DRuffer/eP16VHDL/eP16/compile.cfg

[file:.\..\gpio16.vhd]
Enabled=1
[file:.\..\ram_memory.vhd]
Enabled=1
[file:.\..\uart16.vhd]
Enabled=1
[file:.\..\ep16.vhd]
Enabled=1
[file:.\..\ep16_chip.vhd]
Enabled=1
[View]
Entity=ep32_chip
Architecture=behavioral
TopLevelType=1
[file:.\src\eP16.asdb]
Enabled=1
[file:.\src\eP16.awc]
Enabled=1
