DRuffer/eP16VHDL/eP16/ep32_chip_prim.v

// Verilog netlist produced by program LSE :  version Diamond (64-bit) 3.7.1.502
// Netlist written on Sun Jun 19 19:47:01 2016
//
// Verilog Description of module ep32_chip
//

module ep32_chip (aclk, arst, interrupt_i, uart_i, uart_o, acknowledge_o, 
            ioport);   // c:/lscc/ep16vhdl/ep16_chip.vhd(33[8:17])
    input aclk;   // c:/lscc/ep16vhdl/ep16_chip.vhd(36[2:6])
    input arst;   // c:/lscc/ep16vhdl/ep16_chip.vhd(37[2:6])
    input [4:0]interrupt_i;   // c:/lscc/ep16vhdl/ep16_chip.vhd(38[2:13])
    input uart_i;   // c:/lscc/ep16vhdl/ep16_chip.vhd(39[2:8])
    output uart_o;   // c:/lscc/ep16vhdl/ep16_chip.vhd(41[2:8])
    output acknowledge_o;   // c:/lscc/ep16vhdl/ep16_chip.vhd(42[2:15])
    inout [15:0]ioport;   // c:/lscc/ep16vhdl/ep16_chip.vhd(44[2:8])
    
    wire aclk_c /* synthesis SET_AS_NETWORK=aclk_c, is_clock=1 */ ;   // c:/lscc/ep16vhdl/ep16_chip.vhd(36[2:6])
    wire aclk_N_55 /* synthesis is_clock=1 */ ;   // c:/lscc/ep16vhdl/ep16_chip.vhd(121[9:14])
    
    wire GND_net, VCC_net, arst_c, interrupt_i_c_4, interrupt_i_c_3, 
        interrupt_i_c_2, interrupt_i_c_1, interrupt_i_c_0, uart_i_c, 
        uart_o_c, acknowledge_o_c, n7695;
    wire [15:0]memory_data_o;   // c:/lscc/ep16vhdl/ep16_chip.vhd(122[9:22])
    wire [15:0]memory_data_i;   // c:/lscc/ep16vhdl/ep16_chip.vhd(123[9:22])
    wire [11:0]memory_addr;   // c:/lscc/ep16vhdl/ep16_chip.vhd(124[9:20])
    wire [15:0]system_data_o;   // c:/lscc/ep16vhdl/ep16_chip.vhd(128[9:22])
    
    wire system_read, system_write, n7025, n1171, n1169, n1168, 
        n1167, n1166, n1165, n1164, n1163, n1162;
    wire [15:0]gpio_out;   // c:/lscc/ep16vhdl/ep16_chip.vhd(162[9:17])
    wire [15:0]gpio_dir;   // c:/lscc/ep16vhdl/ep16_chip.vhd(163[9:17])
    
    wire n7694, system_data_o_15__N_2, n7693, system_data_o_15__N_51, 
        system_data_o_15__N_7, system_data_o_15__N_10, system_data_o_15__N_13, 
        system_data_o_15__N_16, system_data_o_15__N_19, system_data_o_15__N_22, 
        system_data_o_15__N_25, system_data_o_15__N_28, n7692, system_data_o_15__N_31, 
        system_data_o_15__N_34, n7691, system_data_o_15__N_37, system_data_o_15__N_40, 
        n7690, system_data_o_15__N_43, system_data_o_15__N_46, system_data_o_15__N_49;
    wire [2:0]slot;   // c:/lscc/ep16vhdl/ep16.vhd(48[9:13])
    wire [4:0]sp;   // c:/lscc/ep16vhdl/ep16.vhd(49[9:11])
    wire [4:0]sp1;   // c:/lscc/ep16vhdl/ep16.vhd(49[12:15])
    wire [4:0]rp;   // c:/lscc/ep16vhdl/ep16.vhd(49[16:18])
    wire [4:0]rp1;   // c:/lscc/ep16vhdl/ep16.vhd(49[19:22])
    wire [16:0]t;   // c:/lscc/ep16vhdl/ep16.vhd(50[9:10])
    wire [16:0]a;   // c:/lscc/ep16vhdl/ep16.vhd(51[9:10])
    wire [16:0]r;   // c:/lscc/ep16vhdl/ep16.vhd(51[11:12])
    wire [2:0]p_sel;   // c:/lscc/ep16vhdl/ep16.vhd(55[9:14])
    wire [15:0]i;   // c:/lscc/ep16vhdl/ep16.vhd(62[9:10])
    wire [15:0]p;   // c:/lscc/ep16vhdl/ep16.vhd(62[11:12])
    wire [15:0]p_in;   // c:/lscc/ep16vhdl/ep16.vhd(62[13:17])
    wire [15:0]p_in_15__N_282;
    
    wire n8631, n7689, n7688, n7687, n7686, n19, n26, n28, n6903, 
        n1411, n6901, n1406, n1401, n1396, n7685, n1391, n1386, 
        n7684, n7683, n1381, n7682, n1376, n7680, n7679, n1371, 
        n1366, n1361, n1356, n1351, n1346, n7678, aclk_c_enable_37, 
        n1341, n7677, n1336, n1335, n1334, n1333, n1332, n1331, 
        n1330, n1329, n1328, n1327, n1326, n1325, n1324, n1323, 
        n1322, n1321, n1317, n1314, n1519, n1518, n1517, n1516, 
        n1515, n1514, n1513, n1512, n1511, n1510, n1509, n1508, 
        n1507, n1506, n1505, n1504, n1503, n1502, n1501, n1500, 
        n1530, n1529, n78, n1424, n7676, n1528, n7675, n1498, 
        n1312, n1309, n1497, n1495, n1494, n1493, n1492, n1491, 
        n1490, n1489, n1488, n1487, n1486, n1485, n1484, n1483, 
        n1482, n1527, n1526, n1525, n1524, n1523, n1416, n1419, 
        n1522, n1521, n1520, n963, n1305, n1481, n1480, n1479, 
        n1478, n1477;
    wire [15:0]baudrate_reg;   // c:/lscc/ep16vhdl/uart16.vhd(50[9:21])
    
    wire hw_xonoff_ff, tx_en;
    wire [15:0]tx_counter;   // c:/lscc/ep16vhdl/uart16.vhd(57[9:19])
    wire [7:0]rx_buffer_reg;   // c:/lscc/ep16vhdl/uart16.vhd(61[9:22])
    
    wire rxb_full, rx_en, rxd_ff, data_o_15__N_441, n1463, n1462, 
        n7161, n6893, n6891, n7674, n7673, n7672, n7671, n1301, 
        n1304, n7670, n1296, aclk_c_enable_21, n1291, n1286, n1281, 
        n1276, n1271, tx_en_N_533, n7407, n7011, n1091, n1093, 
        n1094, n1095, n1096, n1097, n1098, n1099, n7669, n1476, 
        n1475, n6376, n7668, n7667, n8630, rx_irq_o_N_643, n1474, 
        n1536, n1534, n1533, n1532;
    wire [15:0]rx_counter_15__N_609;
    
    wire n1537, n1531, n1473, n1266, n8245, n1261, n1256, n1251, 
        n1246, n1241, n1236, n1231, n1226, n1435, n1432, n1429, 
        n1427, n7411, n6655, n5, n3860, n1084, n9433, n1465, 
        n1464, n1178, n1468, n1466, n1467, n1469, n1470, n1471, 
        n1472, n7001, n8629, n780, n8628, n66, n63, n1996, n8744, 
        n8743, n8741, n8627, n8740, n8738, aclk_c_enable_123, n8626, 
        n8737, n75, n8735, n72, n8734, n8732, n69, n66_adj_901, 
        n69_adj_902, n72_adj_903, n75_adj_904, n78_adj_905, n81, n8731, 
        n7405, aclk_c_enable_16, n8625, n8624, n8623, n8622, n8698, 
        n7611, n7, n3, n1, ioport_out_15, n1853, ioport_out_14, 
        n1855, ioport_out_13, n1857, ioport_out_12, n1859, ioport_out_11, 
        n1861, ioport_out_10, n1863, ioport_out_9, n1865, ioport_out_8, 
        n1867, ioport_out_7, n1869, ioport_out_6, n1871, ioport_out_5, 
        n1873, ioport_out_4, n1875, ioport_out_3, n1877, ioport_out_2, 
        n1879, ioport_out_1, n1881, ioport_out_0, n1883, n8621, 
        n8620, n7595, n8619, n8618, n8617, n8616, n8615, n8614, 
        n8613, n8612, aclk_c_enable_78, n8608, n6835, n8607, n8606, 
        n6833, n8604, n8603, n8602, n8601, n8599, n6537, n8596, 
        n7105, n6010, n30, n4113, n4114, n19_adj_906, n26_adj_907, 
        n28_adj_908, n4, n6, n30_adj_909, n4083, n4084, n19_adj_910, 
        aclk_c_enable_29, n26_adj_911, n1_adj_912, n28_adj_913, n3_adj_914, 
        n30_adj_915, n4053, n4054, n19_adj_916, n26_adj_917, n28_adj_918, 
        n30_adj_919, n4023, n4024, n8675, n7570, n19_adj_920, n7569, 
        n8674, n26_adj_921, n28_adj_922, n8673, n8671, n30_adj_923, 
        n7568, n3993, n3994, n7567, n19_adj_924, n7566, n26_adj_925, 
        n28_adj_926, n7565, n7564, n30_adj_927, n3963, n3964, n8668, 
        n8667, aclk_c_enable_15, n7403, n8666, n8664, n8663, n8592, 
        n8699, n7563, n7562, n8661, n8660, n7561, n7560, aclk_c_enable_18, 
        n7559, n7558, n7557, n7556, n8653, n7555, n7554, n7553, 
        n7552, n7551, n7550, n8651, n7549, n7548, n7547, n7546, 
        n7545, n7544, n7543, n7542, n8640, n18, n7541, n7540, 
        n7733, n7732, n7539, n8637, n7731, n7730, n7729, n7728, 
        n7727, n7726, n7725, n7724, n7723, n8634, n7043, n7722, 
        n8633, n6766, n7721, n7720, n7719, n7717, n7716, n7715, 
        n7714, n7713, n7712, n7711, n7401, n7710, n7709, n7708, 
        n7027, n7707, n7706, n7705, n7704, n8632;
    
    VHI i2 (.Z(VCC_net));
    INV i8039 (.A(aclk_c), .Z(aclk_N_55));   // c:/lscc/ep16vhdl/ep16_chip.vhd(36[2:6])
    FD1P3AX creset_712 (.D(n7539), .SP(aclk_c_enable_16), .CK(aclk_c), 
            .Q(n1301));   // c:/lscc/ep16vhdl/ep16.vhd(47[9:16])
    defparam creset_712.GSR = "ENABLED";
    FD1P3AX creset_724 (.D(n7540), .SP(aclk_c_enable_78), .CK(aclk_c), 
            .Q(n1351));   // c:/lscc/ep16vhdl/ep16.vhd(47[17:24])
    defparam creset_724.GSR = "ENABLED";
    FD1P3AX creset_720 (.D(n7541), .SP(aclk_c_enable_78), .CK(aclk_c), 
            .Q(n1346));   // c:/lscc/ep16vhdl/ep16.vhd(47[17:24])
    defparam creset_720.GSR = "ENABLED";
    FD1P3AX creset_716 (.D(n7542), .SP(aclk_c_enable_78), .CK(aclk_c), 
            .Q(n1341));   // c:/lscc/ep16vhdl/ep16.vhd(47[17:24])
    defparam creset_716.GSR = "ENABLED";
    DPR16X4B n13130 (.DI0(n8674), .DI1(GND_net), .DI2(GND_net), .DI3(GND_net), 
            .WAD0(sp1[0]), .WAD1(sp1[1]), .WAD2(sp1[2]), .WAD3(sp1[3]), 
            .WCK(aclk_c), .WRE(n1309), .RAD0(sp[0]), .RAD1(sp[1]), .RAD2(sp[2]), 
            .RAD3(sp[3]), .DO0(n1314));
    defparam n13130.initval = 64'h0000000000000000;
    DPR16X4B n14310 (.DI0(rp1[4]), .DI1(GND_net), .DI2(GND_net), .DI3(GND_net), 
            .WAD0(rp1[0]), .WAD1(rp1[1]), .WAD2(rp1[2]), .WAD3(rp1[3]), 
            .WCK(aclk_c), .WRE(n1427), .RAD0(rp[0]), .RAD1(rp[1]), .RAD2(rp[2]), 
            .RAD3(rp[3]), .DO0(n1432));
    defparam n14310.initval = 64'h0000000000000000;
    FD1P3AX creset_688 (.D(n7543), .SP(aclk_c_enable_16), .CK(aclk_c), 
            .Q(n1291));   // c:/lscc/ep16vhdl/ep16.vhd(47[9:16])
    defparam creset_688.GSR = "ENABLED";
    FD1P3AX creset_684 (.D(n7544), .SP(aclk_c_enable_16), .CK(aclk_c), 
            .Q(n1286));   // c:/lscc/ep16vhdl/ep16.vhd(47[9:16])
    defparam creset_684.GSR = "ENABLED";
    FD1P3AX creset_640 (.D(n7545), .SP(aclk_c_enable_21), .CK(aclk_c), 
            .Q(n1231));   // c:/lscc/ep16vhdl/ep16.vhd(47[9:16])
    defparam creset_640.GSR = "ENABLED";
    FD1P3AX creset_680 (.D(n7546), .SP(aclk_c_enable_37), .CK(aclk_c), 
            .Q(n1281));   // c:/lscc/ep16vhdl/ep16.vhd(47[9:16])
    defparam creset_680.GSR = "ENABLED";
    FD1P3AX creset_644 (.D(n7547), .SP(aclk_c_enable_21), .CK(aclk_c), 
            .Q(n1236));   // c:/lscc/ep16vhdl/ep16.vhd(47[9:16])
    defparam creset_644.GSR = "ENABLED";
    BB ioport_pad_15 (.I(gpio_out[15]), .T(n1853), .B(ioport[15]), .O(ioport_out_15));   // c:/lscc/ep16vhdl/ep16_chip.vhd(44[2:8])
    FD1P3AX creset (.D(n7548), .SP(aclk_c_enable_78), .CK(aclk_c), .Q(n1416));   // c:/lscc/ep16vhdl/ep16.vhd(47[17:24])
    defparam creset.GSR = "ENABLED";
    DPR16X4B r_stack1 (.DI0(r[13]), .DI1(r[14]), .DI2(r[15]), .DI3(r[16]), 
            .WAD0(rp1[0]), .WAD1(rp1[1]), .WAD2(rp1[2]), .WAD3(rp1[3]), 
            .WCK(aclk_c), .WRE(n1536), .RAD0(rp[0]), .RAD1(rp[1]), .RAD2(rp[2]), 
            .RAD3(rp[3]), .DO0(n1514), .DO1(n1515), .DO2(n1516), .DO3(n1517));
    defparam r_stack1.initval = 64'h0000000000000000;
    FD1P3AX creset_740 (.D(n7549), .SP(aclk_c_enable_78), .CK(aclk_c), 
            .Q(n1371));   // c:/lscc/ep16vhdl/ep16.vhd(47[17:24])
    defparam creset_740.GSR = "ENABLED";
    FD1P3AX creset_772 (.D(n7550), .SP(aclk_c_enable_78), .CK(aclk_c), 
            .Q(n1411));   // c:/lscc/ep16vhdl/ep16.vhd(47[17:24])
    defparam creset_772.GSR = "ENABLED";
    DPR16X4B s_stack1 (.DI0(memory_data_i[13]), .DI1(memory_data_i[14]), 
            .DI2(memory_data_i[15]), .DI3(t[16]), .WAD0(sp1[0]), .WAD1(sp1[1]), 
            .WAD2(sp1[2]), .WAD3(sp1[3]), .WCK(aclk_c), .WRE(n1497), 
            .RAD0(sp[0]), .RAD1(sp[1]), .RAD2(sp[2]), .RAD3(sp[3]), 
            .DO0(n1475), .DO1(n1476), .DO2(n1477), .DO3(n1478));
    defparam s_stack1.initval = 64'h0000000000000000;
    PFUMX i17 (.BLUT(n19_adj_910), .ALUT(n26_adj_911), .C0(data_o_15__N_441), 
          .Z(n28_adj_913));
    ORCALUT4 mux_595_i1_3_lut (.A(gpio_out[0]), .B(baudrate_reg[0]), .C(data_o_15__N_441), 
            .Z(n1178)) /* synthesis lut_function=(A (B+!(C))+!A (B (C))) */ ;   // c:/lscc/ep16vhdl/uart16.vhd(80[2] 95[9])
    defparam mux_595_i1_3_lut.init = 16'hcaca;
    FD1P3AX creset_656 (.D(n7551), .SP(aclk_c_enable_15), .CK(aclk_c), 
            .Q(n1251));   // c:/lscc/ep16vhdl/ep16.vhd(47[9:16])
    defparam creset_656.GSR = "ENABLED";
    FD1P3AX creset_692 (.D(n7552), .SP(aclk_c_enable_16), .CK(aclk_c), 
            .Q(n1296));   // c:/lscc/ep16vhdl/ep16.vhd(47[9:16])
    defparam creset_692.GSR = "ENABLED";
    FD1P3AX creset_648 (.D(n7553), .SP(aclk_c_enable_21), .CK(aclk_c), 
            .Q(n1241));   // c:/lscc/ep16vhdl/ep16.vhd(47[9:16])
    defparam creset_648.GSR = "ENABLED";
    FD1P3AX creset_664 (.D(n7554), .SP(aclk_c_enable_18), .CK(aclk_c), 
            .Q(n1261));   // c:/lscc/ep16vhdl/ep16.vhd(47[9:16])
    defparam creset_664.GSR = "ENABLED";
    FD1P3AX creset_676 (.D(n7555), .SP(aclk_c_enable_37), .CK(aclk_c), 
            .Q(n1276));   // c:/lscc/ep16vhdl/ep16.vhd(47[9:16])
    defparam creset_676.GSR = "ENABLED";
    FD1P3AX creset_768 (.D(n7556), .SP(aclk_c_enable_78), .CK(aclk_c), 
            .Q(n1406));   // c:/lscc/ep16vhdl/ep16.vhd(47[17:24])
    defparam creset_768.GSR = "ENABLED";
    PFUMX i17_adj_206 (.BLUT(n19_adj_906), .ALUT(n26_adj_907), .C0(data_o_15__N_441), 
          .Z(n28_adj_908));
    FD1P3AX creset_636 (.D(n7557), .SP(aclk_c_enable_21), .CK(aclk_c), 
            .Q(n1226));   // c:/lscc/ep16vhdl/ep16.vhd(47[9:16])
    defparam creset_636.GSR = "ENABLED";
    FD1P3AX creset_652 (.D(n7558), .SP(aclk_c_enable_29), .CK(aclk_c), 
            .Q(n1246));   // c:/lscc/ep16vhdl/ep16.vhd(47[9:16])
    defparam creset_652.GSR = "ENABLED";
    gpio gpio1 (.\memory_addr[1] (memory_addr[1]), .tx_en(tx_en), .hw_xonoff_ff(hw_xonoff_ff), 
         .n8616(n8616), .\memory_addr[4] (memory_addr[4]), .n8617(n8617), 
         .\memory_addr[5] (memory_addr[5]), .n7401(n7401), .n8615(n8615), 
         .n7405(n7405), .n8622(n8622), .gpio_out({gpio_out}), .gpio_dir({gpio_dir}), 
         .\baudrate_reg[8] (baudrate_reg[8]), .rxb_full(rxb_full), .ioport_out_8(ioport_out_8), 
         .aclk_c(aclk_c), .aclk_c_enable_123(aclk_c_enable_123), .system_data_o({system_data_o}), 
         .data_o_15__N_441(data_o_15__N_441), .n8245(n8245), .n8603(n8603), 
         .n8602(n8602), .n8618(n8618), .n18(n18), .n8604(n8604), .n8608(n8608), 
         .ioport_out_13(ioport_out_13), .n8592(n8592), .n1084(n1084), 
         .ioport_out_15(ioport_out_15), .ioport_out_14(ioport_out_14), .\rx_buffer_reg[0] (rx_buffer_reg[0]), 
         .n1163(n1163), .n7611(n7611), .n1099(n1099), .n1164(n1164), 
         .n1098(n1098), .n1165(n1165), .n1097(n1097), .n1166(n1166), 
         .n1096(n1096), .n1167(n1167), .n1095(n1095), .n1168(n1168), 
         .n1094(n1094), .n1169(n1169), .n1093(n1093), .n1091(n1091), 
         .n1178(n1178), .n1162(n1162), .ioport_out_12(ioport_out_12), 
         .n7407(n7407), .ioport_out_11(ioport_out_11), .ioport_out_10(ioport_out_10), 
         .ioport_out_9(ioport_out_9), .n1171(n1171), .ioport_out_7(ioport_out_7), 
         .\rx_buffer_reg[7] (rx_buffer_reg[7]), .ioport_out_0(ioport_out_0));   // c:/lscc/ep16vhdl/ep16_chip.vhd(252[11:15])
    ORCALUT4 i3516_2_lut_rep_250_3_lut (.A(n8664), .B(n1305), .C(n1334), 
            .Z(n8630)) /* synthesis lut_function=(A (B (C))) */ ;   // c:/lscc/ep16vhdl/ep16.vhd(47[9:16])
    defparam i3516_2_lut_rep_250_3_lut.init = 16'h8080;
    FD1P3AX creset_660 (.D(n7559), .SP(aclk_c_enable_29), .CK(aclk_c), 
            .Q(n1256));   // c:/lscc/ep16vhdl/ep16.vhd(47[9:16])
    defparam creset_660.GSR = "ENABLED";
    FD1P3AX creset_672 (.D(n7560), .SP(aclk_c_enable_37), .CK(aclk_c), 
            .Q(n1271));   // c:/lscc/ep16vhdl/ep16.vhd(47[9:16])
    defparam creset_672.GSR = "ENABLED";
    ORCALUT4 i1188_4_lut (.A(system_data_o_15__N_13), .B(system_data_o_15__N_51), 
            .C(memory_data_i[12]), .D(system_write), .Z(system_data_o[12])) /* synthesis lut_function=(A (B (C+!(D)))+!A (B (C (D)))) */ ;   // c:/lscc/ep16vhdl/ep16_chip.vhd(198[2:15])
    defparam i1188_4_lut.init = 16'hc088;
    ORCALUT4 mux_470_i13_4_lut (.A(memory_data_o[12]), .B(n1096), .C(n8618), 
            .D(n6537), .Z(system_data_o_15__N_13)) /* synthesis lut_function=(A (B+!(C (D)))+!A (B (C)+!B !((D)+!C))) */ ;   // c:/lscc/ep16vhdl/uart16.vhd(80[2] 95[9])
    defparam mux_470_i13_4_lut.init = 16'hcafa;
    ORCALUT4 i3404_4_lut_then_4_lut (.A(n8660), .B(n66_adj_901), .C(rx_irq_o_N_643), 
            .D(baudrate_reg[5]), .Z(n8732)) /* synthesis lut_function=(A (B (C+(D))+!B !(C+!(D)))+!A (B (C))) */ ;   // c:/lscc/ep16vhdl/uart16.vhd(39[3:11])
    defparam i3404_4_lut_then_4_lut.init = 16'hcac0;
    ORCALUT4 i3404_4_lut_else_4_lut (.A(baudrate_reg[6]), .B(rxd_ff), .Z(n8731)) /* synthesis lut_function=(!((B)+!A)) */ ;   // c:/lscc/ep16vhdl/uart16.vhd(39[3:11])
    defparam i3404_4_lut_else_4_lut.init = 16'h2222;
    ORCALUT4 i3373_4_lut_then_4_lut (.A(n8660), .B(n69_adj_902), .C(rx_irq_o_N_643), 
            .D(baudrate_reg[4]), .Z(n8735)) /* synthesis lut_function=(A (B (C+(D))+!B !(C+!(D)))+!A (B (C))) */ ;   // c:/lscc/ep16vhdl/uart16.vhd(39[3:11])
    defparam i3373_4_lut_then_4_lut.init = 16'hcac0;
    ORCALUT4 i3373_4_lut_else_4_lut (.A(baudrate_reg[5]), .B(rxd_ff), .Z(n8734)) /* synthesis lut_function=(!((B)+!A)) */ ;   // c:/lscc/ep16vhdl/uart16.vhd(39[3:11])
    defparam i3373_4_lut_else_4_lut.init = 16'h2222;
    ORCALUT4 i3342_4_lut_then_4_lut (.A(n8660), .B(n72_adj_903), .C(rx_irq_o_N_643), 
            .D(baudrate_reg[3]), .Z(n8738)) /* synthesis lut_function=(A (B (C+(D))+!B !(C+!(D)))+!A (B (C))) */ ;   // c:/lscc/ep16vhdl/uart16.vhd(39[3:11])
    defparam i3342_4_lut_then_4_lut.init = 16'hcac0;
    ORCALUT4 i3342_4_lut_else_4_lut (.A(baudrate_reg[4]), .B(rxd_ff), .Z(n8737)) /* synthesis lut_function=(!((B)+!A)) */ ;   // c:/lscc/ep16vhdl/uart16.vhd(39[3:11])
    defparam i3342_4_lut_else_4_lut.init = 16'h2222;
    ORCALUT4 i3514_2_lut_rep_249_3_lut (.A(n8664), .B(n1305), .C(n1336), 
            .Z(n8629)) /* synthesis lut_function=(A (B (C))) */ ;   // c:/lscc/ep16vhdl/ep16.vhd(47[9:16])
    defparam i3514_2_lut_rep_249_3_lut.init = 16'h8080;
    ORCALUT4 i3311_4_lut_then_4_lut (.A(n8660), .B(n75_adj_904), .C(rx_irq_o_N_643), 
            .D(baudrate_reg[2]), .Z(n8741)) /* synthesis lut_function=(A (B (C+(D))+!B !(C+!(D)))+!A (B (C))) */ ;   // c:/lscc/ep16vhdl/uart16.vhd(39[3:11])
    defparam i3311_4_lut_then_4_lut.init = 16'hcac0;
    FD1P3AX creset_668 (.D(n7561), .SP(aclk_c_enable_37), .CK(aclk_c), 
            .Q(n1266));   // c:/lscc/ep16vhdl/ep16.vhd(47[9:16])
    defparam creset_668.GSR = "ENABLED";
    FD1P3AX creset_764 (.D(n7562), .SP(aclk_c_enable_78), .CK(aclk_c), 
            .Q(n1401));   // c:/lscc/ep16vhdl/ep16.vhd(47[17:24])
    defparam creset_764.GSR = "ENABLED";
    ORCALUT4 i3311_4_lut_else_4_lut (.A(baudrate_reg[3]), .B(rxd_ff), .Z(n8740)) /* synthesis lut_function=(!((B)+!A)) */ ;   // c:/lscc/ep16vhdl/uart16.vhd(39[3:11])
    defparam i3311_4_lut_else_4_lut.init = 16'h2222;
    ORCALUT4 i1190_4_lut (.A(system_data_o_15__N_7), .B(system_data_o_15__N_51), 
            .C(memory_data_i[14]), .D(system_write), .Z(system_data_o[14])) /* synthesis lut_function=(A (B (C+!(D)))+!A (B (C (D)))) */ ;   // c:/lscc/ep16vhdl/ep16_chip.vhd(198[2:15])
    defparam i1190_4_lut.init = 16'hc088;
    FD1P3AX creset_760 (.D(n7563), .SP(aclk_c_enable_78), .CK(aclk_c), 
            .Q(n1396));   // c:/lscc/ep16vhdl/ep16.vhd(47[17:24])
    defparam creset_760.GSR = "ENABLED";
    FD1P3AX creset_736 (.D(n7564), .SP(aclk_c_enable_78), .CK(aclk_c), 
            .Q(n1366));   // c:/lscc/ep16vhdl/ep16.vhd(47[17:24])
    defparam creset_736.GSR = "ENABLED";
    FD1P3AX creset_732 (.D(n7565), .SP(aclk_c_enable_78), .CK(aclk_c), 
            .Q(n1361));   // c:/lscc/ep16vhdl/ep16.vhd(47[17:24])
    defparam creset_732.GSR = "ENABLED";
    FD1P3AX creset_756 (.D(n7566), .SP(aclk_c_enable_78), .CK(aclk_c), 
            .Q(n1391));   // c:/lscc/ep16vhdl/ep16.vhd(47[17:24])
    defparam creset_756.GSR = "ENABLED";
    FD1P3AX creset_752 (.D(n7567), .SP(aclk_c_enable_78), .CK(aclk_c), 
            .Q(n1386));   // c:/lscc/ep16vhdl/ep16.vhd(47[17:24])
    defparam creset_752.GSR = "ENABLED";
    ORCALUT4 mux_470_i15_4_lut (.A(memory_data_o[14]), .B(n1098), .C(n8618), 
            .D(n6537), .Z(system_data_o_15__N_7)) /* synthesis lut_function=(A (B+!(C (D)))+!A (B (C)+!B !((D)+!C))) */ ;   // c:/lscc/ep16vhdl/uart16.vhd(80[2] 95[9])
    defparam mux_470_i15_4_lut.init = 16'hcafa;
    FD1P3AX creset_748 (.D(n7568), .SP(aclk_c_enable_78), .CK(aclk_c), 
            .Q(n1381));   // c:/lscc/ep16vhdl/ep16.vhd(47[17:24])
    defparam creset_748.GSR = "ENABLED";
    FD1P3AX creset_744 (.D(n7569), .SP(aclk_c_enable_78), .CK(aclk_c), 
            .Q(n1376));   // c:/lscc/ep16vhdl/ep16.vhd(47[17:24])
    defparam creset_744.GSR = "ENABLED";
    DPR16X4B n14280 (.DI0(n1500), .DI1(GND_net), .DI2(GND_net), .DI3(GND_net), 
            .WAD0(rp1[0]), .WAD1(rp1[1]), .WAD2(rp1[2]), .WAD3(rp1[3]), 
            .WCK(aclk_c), .WRE(n1424), .RAD0(rp[0]), .RAD1(rp[1]), .RAD2(rp[2]), 
            .RAD3(rp[3]), .DO0(n1429));
    defparam n14280.initval = 64'h0000000000000000;
    ORCALUT4 i3280_4_lut_then_4_lut (.A(n8660), .B(n78_adj_905), .C(rx_irq_o_N_643), 
            .D(baudrate_reg[1]), .Z(n8744)) /* synthesis lut_function=(A (B (C+(D))+!B !(C+!(D)))+!A (B (C))) */ ;   // c:/lscc/ep16vhdl/uart16.vhd(39[3:11])
    defparam i3280_4_lut_then_4_lut.init = 16'hcac0;
    DPR16X4B s_stack0 (.DI0(memory_data_i[13]), .DI1(memory_data_i[14]), 
            .DI2(memory_data_i[15]), .DI3(t[16]), .WAD0(sp1[0]), .WAD1(sp1[1]), 
            .WAD2(sp1[2]), .WAD3(sp1[3]), .WCK(aclk_c), .WRE(n1498), 
            .RAD0(sp[0]), .RAD1(sp[1]), .RAD2(sp[2]), .RAD3(sp[3]), 
            .DO0(n1492), .DO1(n1493), .DO2(n1494), .DO3(n1495));
    defparam s_stack0.initval = 64'h0000000000000000;
    ORCALUT4 i3280_4_lut_else_4_lut (.A(baudrate_reg[2]), .B(rxd_ff), .Z(n8743)) /* synthesis lut_function=(!((B)+!A)) */ ;   // c:/lscc/ep16vhdl/uart16.vhd(39[3:11])
    defparam i3280_4_lut_else_4_lut.init = 16'h2222;
    DPR16X4B s_stack2 (.DI0(memory_data_i[9]), .DI1(memory_data_i[10]), 
            .DI2(memory_data_i[11]), .DI3(memory_data_i[12]), .WAD0(sp1[0]), 
            .WAD1(sp1[1]), .WAD2(sp1[2]), .WAD3(sp1[3]), .WCK(aclk_c), 
            .WRE(n1497), .RAD0(sp[0]), .RAD1(sp[1]), .RAD2(sp[2]), .RAD3(sp[3]), 
            .DO0(n1471), .DO1(n1472), .DO2(n1473), .DO3(n1474));
    defparam s_stack2.initval = 64'h0000000000000000;
    DPR16X4B s_stack3 (.DI0(memory_data_i[5]), .DI1(memory_data_i[6]), .DI2(memory_data_i[7]), 
            .DI3(memory_data_i[8]), .WAD0(sp1[0]), .WAD1(sp1[1]), .WAD2(sp1[2]), 
            .WAD3(sp1[3]), .WCK(aclk_c), .WRE(n1497), .RAD0(sp[0]), 
            .RAD1(sp[1]), .RAD2(sp[2]), .RAD3(sp[3]), .DO0(n1467), .DO1(n1468), 
            .DO2(n1469), .DO3(n1470));
    defparam s_stack3.initval = 64'h0000000000000000;
    DPR16X4B s_stack4 (.DI0(memory_data_i[1]), .DI1(memory_data_i[2]), .DI2(memory_data_i[3]), 
            .DI3(memory_data_i[4]), .WAD0(sp1[0]), .WAD1(sp1[1]), .WAD2(sp1[2]), 
            .WAD3(sp1[3]), .WCK(aclk_c), .WRE(n1497), .RAD0(sp[0]), 
            .RAD1(sp[1]), .RAD2(sp[2]), .RAD3(sp[3]), .DO0(n1463), .DO1(n1464), 
            .DO2(n1465), .DO3(n1466));
    defparam s_stack4.initval = 64'h0000000000000000;
    DPR16X4B s_stack5 (.DI0(memory_data_i[0]), .DI1(GND_net), .DI2(GND_net), 
            .DI3(GND_net), .WAD0(sp1[0]), .WAD1(sp1[1]), .WAD2(sp1[2]), 
            .WAD3(sp1[3]), .WCK(aclk_c), .WRE(n1497), .RAD0(sp[0]), 
            .RAD1(sp[1]), .RAD2(sp[2]), .RAD3(sp[3]), .DO0(n1462));
    defparam s_stack5.initval = 64'h0000000000000000;
    DPR16X4B s_stack6 (.DI0(memory_data_i[9]), .DI1(memory_data_i[10]), 
            .DI2(memory_data_i[11]), .DI3(memory_data_i[12]), .WAD0(sp1[0]), 
            .WAD1(sp1[1]), .WAD2(sp1[2]), .WAD3(sp1[3]), .WCK(aclk_c), 
            .WRE(n1498), .RAD0(sp[0]), .RAD1(sp[1]), .RAD2(sp[2]), .RAD3(sp[3]), 
            .DO0(n1488), .DO1(n1489), .DO2(n1490), .DO3(n1491));
    defparam s_stack6.initval = 64'h0000000000000000;
    DPR16X4B s_stack7 (.DI0(memory_data_i[5]), .DI1(memory_data_i[6]), .DI2(memory_data_i[7]), 
            .DI3(memory_data_i[8]), .WAD0(sp1[0]), .WAD1(sp1[1]), .WAD2(sp1[2]), 
            .WAD3(sp1[3]), .WCK(aclk_c), .WRE(n1498), .RAD0(sp[0]), 
            .RAD1(sp[1]), .RAD2(sp[2]), .RAD3(sp[3]), .DO0(n1484), .DO1(n1485), 
            .DO2(n1486), .DO3(n1487));
    defparam s_stack7.initval = 64'h0000000000000000;
    DPR16X4B s_stack8 (.DI0(memory_data_i[1]), .DI1(memory_data_i[2]), .DI2(memory_data_i[3]), 
            .DI3(memory_data_i[4]), .WAD0(sp1[0]), .WAD1(sp1[1]), .WAD2(sp1[2]), 
            .WAD3(sp1[3]), .WCK(aclk_c), .WRE(n1498), .RAD0(sp[0]), 
            .RAD1(sp[1]), .RAD2(sp[2]), .RAD3(sp[3]), .DO0(n1480), .DO1(n1481), 
            .DO2(n1482), .DO3(n1483));
    defparam s_stack8.initval = 64'h0000000000000000;
    DPR16X4B r_stack0 (.DI0(r[13]), .DI1(r[14]), .DI2(r[15]), .DI3(r[16]), 
            .WAD0(rp1[0]), .WAD1(rp1[1]), .WAD2(rp1[2]), .WAD3(rp1[3]), 
            .WCK(aclk_c), .WRE(n1537), .RAD0(rp[0]), .RAD1(rp[1]), .RAD2(rp[2]), 
            .RAD3(rp[3]), .DO0(n1531), .DO1(n1532), .DO2(n1533), .DO3(n1534));
    defparam r_stack0.initval = 64'h0000000000000000;
    DPR16X4B s_stack9 (.DI0(memory_data_i[0]), .DI1(GND_net), .DI2(GND_net), 
            .DI3(GND_net), .WAD0(sp1[0]), .WAD1(sp1[1]), .WAD2(sp1[2]), 
            .WAD3(sp1[3]), .WCK(aclk_c), .WRE(n1498), .RAD0(sp[0]), 
            .RAD1(sp[1]), .RAD2(sp[2]), .RAD3(sp[3]), .DO0(n1479));
    defparam s_stack9.initval = 64'h0000000000000000;
    DPR16X4B n13160 (.DI0(sp1[4]), .DI1(GND_net), .DI2(GND_net), .DI3(GND_net), 
            .WAD0(sp1[0]), .WAD1(sp1[1]), .WAD2(sp1[2]), .WAD3(sp1[3]), 
            .WCK(aclk_c), .WRE(n1312), .RAD0(sp[0]), .RAD1(sp[1]), .RAD2(sp[2]), 
            .RAD3(sp[3]), .DO0(n1317));
    defparam n13160.initval = 64'h0000000000000000;
    DPR16X4B r_stack2 (.DI0(r[9]), .DI1(r[10]), .DI2(r[11]), .DI3(r[12]), 
            .WAD0(rp1[0]), .WAD1(rp1[1]), .WAD2(rp1[2]), .WAD3(rp1[3]), 
            .WCK(aclk_c), .WRE(n1536), .RAD0(rp[0]), .RAD1(rp[1]), .RAD2(rp[2]), 
            .RAD3(rp[3]), .DO0(n1510), .DO1(n1511), .DO2(n1512), .DO3(n1513));
    defparam r_stack2.initval = 64'h0000000000000000;
    DPR16X4B r_stack3 (.DI0(r[5]), .DI1(r[6]), .DI2(r[7]), .DI3(r[8]), 
            .WAD0(rp1[0]), .WAD1(rp1[1]), .WAD2(rp1[2]), .WAD3(rp1[3]), 
            .WCK(aclk_c), .WRE(n1536), .RAD0(rp[0]), .RAD1(rp[1]), .RAD2(rp[2]), 
            .RAD3(rp[3]), .DO0(n1506), .DO1(n1507), .DO2(n1508), .DO3(n1509));
    defparam r_stack3.initval = 64'h0000000000000000;
    DPR16X4B r_stack4 (.DI0(r[1]), .DI1(r[2]), .DI2(r[3]), .DI3(r[4]), 
            .WAD0(rp1[0]), .WAD1(rp1[1]), .WAD2(rp1[2]), .WAD3(rp1[3]), 
            .WCK(aclk_c), .WRE(n1536), .RAD0(rp[0]), .RAD1(rp[1]), .RAD2(rp[2]), 
            .RAD3(rp[3]), .DO0(n1502), .DO1(n1503), .DO2(n1504), .DO3(n1505));
    defparam r_stack4.initval = 64'h0000000000000000;
    DPR16X4B r_stack5 (.DI0(r[0]), .DI1(GND_net), .DI2(GND_net), .DI3(GND_net), 
            .WAD0(rp1[0]), .WAD1(rp1[1]), .WAD2(rp1[2]), .WAD3(rp1[3]), 
            .WCK(aclk_c), .WRE(n1536), .RAD0(rp[0]), .RAD1(rp[1]), .RAD2(rp[2]), 
            .RAD3(rp[3]), .DO0(n1501));
    defparam r_stack5.initval = 64'h0000000000000000;
    DPR16X4B r_stack6 (.DI0(r[9]), .DI1(r[10]), .DI2(r[11]), .DI3(r[12]), 
            .WAD0(rp1[0]), .WAD1(rp1[1]), .WAD2(rp1[2]), .WAD3(rp1[3]), 
            .WCK(aclk_c), .WRE(n1537), .RAD0(rp[0]), .RAD1(rp[1]), .RAD2(rp[2]), 
            .RAD3(rp[3]), .DO0(n1527), .DO1(n1528), .DO2(n1529), .DO3(n1530));
    defparam r_stack6.initval = 64'h0000000000000000;
    DPR16X4B r_stack7 (.DI0(r[5]), .DI1(r[6]), .DI2(r[7]), .DI3(r[8]), 
            .WAD0(rp1[0]), .WAD1(rp1[1]), .WAD2(rp1[2]), .WAD3(rp1[3]), 
            .WCK(aclk_c), .WRE(n1537), .RAD0(rp[0]), .RAD1(rp[1]), .RAD2(rp[2]), 
            .RAD3(rp[3]), .DO0(n1523), .DO1(n1524), .DO2(n1525), .DO3(n1526));
    defparam r_stack7.initval = 64'h0000000000000000;
    DPR16X4B r_stack8 (.DI0(r[1]), .DI1(r[2]), .DI2(r[3]), .DI3(r[4]), 
            .WAD0(rp1[0]), .WAD1(rp1[1]), .WAD2(rp1[2]), .WAD3(rp1[3]), 
            .WCK(aclk_c), .WRE(n1537), .RAD0(rp[0]), .RAD1(rp[1]), .RAD2(rp[2]), 
            .RAD3(rp[3]), .DO0(n1519), .DO1(n1520), .DO2(n1521), .DO3(n1522));
    defparam r_stack8.initval = 64'h0000000000000000;
    DPR16X4B r_stack9 (.DI0(r[0]), .DI1(GND_net), .DI2(GND_net), .DI3(GND_net), 
            .WAD0(rp1[0]), .WAD1(rp1[1]), .WAD2(rp1[2]), .WAD3(rp1[3]), 
            .WCK(aclk_c), .WRE(n1537), .RAD0(rp[0]), .RAD1(rp[1]), .RAD2(rp[2]), 
            .RAD3(rp[3]), .DO0(n1518));
    defparam r_stack9.initval = 64'h0000000000000000;
    ORCALUT4 i6747_4_lut (.A(n8617), .B(memory_addr[5]), .C(n8615), .D(n8616), 
            .Z(n7411)) /* synthesis lut_function=(A+(B+(C+(D)))) */ ;
    defparam i6747_4_lut.init = 16'hfffe;
    ORCALUT4 i7214_3_lut (.A(n30_adj_909), .B(ioport_out_5), .C(memory_addr[1]), 
            .Z(n19_adj_910)) /* synthesis lut_function=(A (B+!(C))+!A (B (C))) */ ;   // c:/lscc/ep16vhdl/uart16.vhd(37[3:9])
    defparam i7214_3_lut.init = 16'hcaca;
    ORCALUT4 i1191_4_lut (.A(system_data_o_15__N_2), .B(system_data_o_15__N_51), 
            .C(memory_data_i[15]), .D(system_write), .Z(system_data_o[15])) /* synthesis lut_function=(A (B (C+!(D)))+!A (B (C (D)))) */ ;   // c:/lscc/ep16vhdl/ep16_chip.vhd(198[2:15])
    defparam i1191_4_lut.init = 16'hc088;
    PFUMX i17_adj_207 (.BLUT(n19_adj_924), .ALUT(n26_adj_925), .C0(data_o_15__N_441), 
          .Z(n28_adj_926));
    ORCALUT4 i3525_2_lut_rep_232_3_lut (.A(n8664), .B(n1305), .C(n1325), 
            .Z(n8612)) /* synthesis lut_function=(A (B (C))) */ ;   // c:/lscc/ep16vhdl/ep16.vhd(47[9:16])
    defparam i3525_2_lut_rep_232_3_lut.init = 16'h8080;
    ORCALUT4 i29_3_lut (.A(gpio_out[5]), .B(gpio_dir[5]), .C(n8622), .Z(n30_adj_909)) /* synthesis lut_function=(A (B+!(C))+!A (B (C))) */ ;   // c:/lscc/ep16vhdl/ep16_chip.vhd(124[9:20])
    defparam i29_3_lut.init = 16'hcaca;
    ORCALUT4 mux_470_i16_4_lut (.A(memory_data_o[15]), .B(n1099), .C(n8618), 
            .D(n6537), .Z(system_data_o_15__N_2)) /* synthesis lut_function=(A (B+!(C (D)))+!A (B (C)+!B !((D)+!C))) */ ;   // c:/lscc/ep16vhdl/uart16.vhd(80[2] 95[9])
    defparam mux_470_i16_4_lut.init = 16'hcafa;
    ORCALUT4 i1161_1_lut (.A(gpio_dir[14]), .Z(n1855)) /* synthesis lut_function=(!(A)) */ ;   // c:/lscc/ep16vhdl/ep16_chip.vhd(44[2:8])
    defparam i1161_1_lut.init = 16'h5555;
    ORCALUT4 i1162_1_lut (.A(gpio_dir[13]), .Z(n1857)) /* synthesis lut_function=(!(A)) */ ;   // c:/lscc/ep16vhdl/ep16_chip.vhd(44[2:8])
    defparam i1162_1_lut.init = 16'h5555;
    PFUMX i17_adj_208 (.BLUT(n19), .ALUT(n26), .C0(data_o_15__N_441), 
          .Z(n28));
    ORCALUT4 i6906_3_lut (.A(n1356), .B(n7161), .Z(n7570)) /* synthesis lut_function=(A+(B)) */ ;
    defparam i6906_3_lut.init = 16'heeee;
    PFUMX i29 (.BLUT(n6766), .ALUT(n6655), .C0(n8637), .Z(n18));
    ORCALUT4 i1163_1_lut (.A(gpio_dir[12]), .Z(n1859)) /* synthesis lut_function=(!(A)) */ ;   // c:/lscc/ep16vhdl/ep16_chip.vhd(44[2:8])
    defparam i1163_1_lut.init = 16'h5555;
    ORCALUT4 i1164_1_lut (.A(gpio_dir[11]), .Z(n1861)) /* synthesis lut_function=(!(A)) */ ;   // c:/lscc/ep16vhdl/ep16_chip.vhd(44[2:8])
    defparam i1164_1_lut.init = 16'h5555;
    ORCALUT4 i1165_1_lut (.A(gpio_dir[10]), .Z(n1863)) /* synthesis lut_function=(!(A)) */ ;   // c:/lscc/ep16vhdl/ep16_chip.vhd(44[2:8])
    defparam i1165_1_lut.init = 16'h5555;
    ORCALUT4 i15_4_lut (.A(memory_addr[1]), .B(rx_buffer_reg[5]), .C(n8622), 
            .D(baudrate_reg[5]), .Z(n26_adj_911)) /* synthesis lut_function=(A (B (C))+!A !(C+!(D))) */ ;   // c:/lscc/ep16vhdl/ep16_chip.vhd(124[9:20])
    defparam i15_4_lut.init = 16'h8580;
    ORCALUT4 i1166_1_lut (.A(gpio_dir[9]), .Z(n1865)) /* synthesis lut_function=(!(A)) */ ;   // c:/lscc/ep16vhdl/ep16_chip.vhd(44[2:8])
    defparam i1166_1_lut.init = 16'h5555;
    ORCALUT4 i1167_1_lut (.A(gpio_dir[8]), .Z(n1867)) /* synthesis lut_function=(!(A)) */ ;   // c:/lscc/ep16vhdl/ep16_chip.vhd(44[2:8])
    defparam i1167_1_lut.init = 16'h5555;
    ORCALUT4 i1168_1_lut (.A(gpio_dir[7]), .Z(n1869)) /* synthesis lut_function=(!(A)) */ ;   // c:/lscc/ep16vhdl/ep16_chip.vhd(44[2:8])
    defparam i1168_1_lut.init = 16'h5555;
    ORCALUT4 i1169_1_lut (.A(gpio_dir[6]), .Z(n1871)) /* synthesis lut_function=(!(A)) */ ;   // c:/lscc/ep16vhdl/ep16_chip.vhd(44[2:8])
    defparam i1169_1_lut.init = 16'h5555;
    ORCALUT4 i1170_1_lut (.A(gpio_dir[5]), .Z(n1873)) /* synthesis lut_function=(!(A)) */ ;   // c:/lscc/ep16vhdl/ep16_chip.vhd(44[2:8])
    defparam i1170_1_lut.init = 16'h5555;
    ORCALUT4 i1171_1_lut (.A(gpio_dir[4]), .Z(n1875)) /* synthesis lut_function=(!(A)) */ ;   // c:/lscc/ep16vhdl/ep16_chip.vhd(44[2:8])
    defparam i1171_1_lut.init = 16'h5555;
    ORCALUT4 i1172_1_lut (.A(gpio_dir[3]), .Z(n1877)) /* synthesis lut_function=(!(A)) */ ;   // c:/lscc/ep16vhdl/ep16_chip.vhd(44[2:8])
    defparam i1172_1_lut.init = 16'h5555;
    ORCALUT4 i1173_1_lut (.A(gpio_dir[2]), .Z(n1879)) /* synthesis lut_function=(!(A)) */ ;   // c:/lscc/ep16vhdl/ep16_chip.vhd(44[2:8])
    defparam i1173_1_lut.init = 16'h5555;
    ORCALUT4 i1174_1_lut (.A(gpio_dir[1]), .Z(n1881)) /* synthesis lut_function=(!(A)) */ ;   // c:/lscc/ep16vhdl/ep16_chip.vhd(44[2:8])
    defparam i1174_1_lut.init = 16'h5555;
    ORCALUT4 i1175_1_lut (.A(gpio_dir[0]), .Z(n1883)) /* synthesis lut_function=(!(A)) */ ;   // c:/lscc/ep16vhdl/ep16_chip.vhd(44[2:8])
    defparam i1175_1_lut.init = 16'h5555;
    ORCALUT4 i1189_4_lut (.A(system_data_o_15__N_10), .B(system_data_o_15__N_51), 
            .C(memory_data_i[13]), .D(system_write), .Z(system_data_o[13])) /* synthesis lut_function=(A (B (C+!(D)))+!A (B (C (D)))) */ ;   // c:/lscc/ep16vhdl/ep16_chip.vhd(198[2:15])
    defparam i1189_4_lut.init = 16'hc088;
    ORCALUT4 mux_470_i14_4_lut (.A(memory_data_o[13]), .B(n1097), .C(n8618), 
            .D(n6537), .Z(system_data_o_15__N_10)) /* synthesis lut_function=(A (B+!(C (D)))+!A (B (C)+!B !((D)+!C))) */ ;   // c:/lscc/ep16vhdl/uart16.vhd(80[2] 95[9])
    defparam mux_470_i14_4_lut.init = 16'hcafa;
    ORCALUT4 mux_595_i16_3_lut (.A(gpio_out[15]), .B(baudrate_reg[15]), 
            .C(data_o_15__N_441), .Z(n1163)) /* synthesis lut_function=(A (B+!(C))+!A (B (C))) */ ;   // c:/lscc/ep16vhdl/uart16.vhd(80[2] 95[9])
    defparam mux_595_i16_3_lut.init = 16'hcaca;
    ORCALUT4 i3248_3_lut (.A(n3963), .B(baudrate_reg[1]), .C(n780), .Z(n3964)) /* synthesis lut_function=(A (B+!(C))+!A (B (C))) */ ;
    defparam i3248_3_lut.init = 16'hcaca;
    ORCALUT4 i1_4_lut (.A(n7403), .B(n8621), .C(n8615), .D(n6835), .Z(data_o_15__N_441)) /* synthesis lut_function=(!(A+(B+(C+!(D))))) */ ;
    defparam i1_4_lut.init = 16'h0100;
    ORCALUT4 i3247_4_lut (.A(tx_counter[1]), .B(n78), .C(n8651), .D(tx_en_N_533), 
            .Z(n3963)) /* synthesis lut_function=(A (B ((D)+!C)+!B !(C))+!A (B (C (D)))) */ ;
    defparam i3247_4_lut.init = 16'hca0a;
    ORCALUT4 i6739_4_lut (.A(n8616), .B(memory_addr[5]), .C(n8617), .D(memory_addr[4]), 
            .Z(n7403)) /* synthesis lut_function=(A+(B+(C+(D)))) */ ;
    defparam i6739_4_lut.init = 16'hfffe;
    ORCALUT4 i3279_3_lut (.A(n3993), .B(baudrate_reg[2]), .C(n780), .Z(n3994)) /* synthesis lut_function=(A (B+!(C))+!A (B (C))) */ ;
    defparam i3279_3_lut.init = 16'hcaca;
    ORCALUT4 i3278_4_lut (.A(tx_counter[2]), .B(n75), .C(n8651), .D(tx_en_N_533), 
            .Z(n3993)) /* synthesis lut_function=(A (B ((D)+!C)+!B !(C))+!A (B (C (D)))) */ ;
    defparam i3278_4_lut.init = 16'hca0a;
    ORCALUT4 i3310_3_lut (.A(n4023), .B(baudrate_reg[3]), .C(n780), .Z(n4024)) /* synthesis lut_function=(A (B+!(C))+!A (B (C))) */ ;
    defparam i3310_3_lut.init = 16'hcaca;
    ORCALUT4 i3309_4_lut (.A(tx_counter[3]), .B(n72), .C(n8651), .D(tx_en_N_533), 
            .Z(n4023)) /* synthesis lut_function=(A (B ((D)+!C)+!B !(C))+!A (B (C (D)))) */ ;
    defparam i3309_4_lut.init = 16'hca0a;
    ORCALUT4 i3341_3_lut (.A(n4053), .B(baudrate_reg[4]), .C(n780), .Z(n4054)) /* synthesis lut_function=(A (B+!(C))+!A (B (C))) */ ;
    defparam i3341_3_lut.init = 16'hcaca;
    ORCALUT4 i3340_4_lut (.A(tx_counter[4]), .B(n69), .C(n8651), .D(tx_en_N_533), 
            .Z(n4053)) /* synthesis lut_function=(A (B ((D)+!C)+!B !(C))+!A (B (C (D)))) */ ;
    defparam i3340_4_lut.init = 16'hca0a;
    ORCALUT4 i3372_3_lut (.A(n4083), .B(baudrate_reg[5]), .C(n780), .Z(n4084)) /* synthesis lut_function=(A (B+!(C))+!A (B (C))) */ ;
    defparam i3372_3_lut.init = 16'hcaca;
    ORCALUT4 i3371_4_lut (.A(tx_counter[5]), .B(n66), .C(n8651), .D(tx_en_N_533), 
            .Z(n4083)) /* synthesis lut_function=(A (B ((D)+!C)+!B !(C))+!A (B (C (D)))) */ ;
    defparam i3371_4_lut.init = 16'hca0a;
    ORCALUT4 i3523_2_lut_rep_233_3_lut (.A(n8664), .B(n1305), .C(n1327), 
            .Z(n8613)) /* synthesis lut_function=(A (B (C))) */ ;   // c:/lscc/ep16vhdl/ep16.vhd(47[9:16])
    defparam i3523_2_lut_rep_233_3_lut.init = 16'h8080;
    ORCALUT4 i3403_3_lut (.A(n4113), .B(baudrate_reg[6]), .C(n780), .Z(n4114)) /* synthesis lut_function=(A (B+!(C))+!A (B (C))) */ ;
    defparam i3403_3_lut.init = 16'hcaca;
    ORCALUT4 i3402_4_lut (.A(tx_counter[6]), .B(n63), .C(n8651), .D(tx_en_N_533), 
            .Z(n4113)) /* synthesis lut_function=(A (B ((D)+!C)+!B !(C))+!A (B (C (D)))) */ ;
    defparam i3402_4_lut.init = 16'hca0a;
    ORCALUT4 i7212_3_lut (.A(n30), .B(ioport_out_6), .C(memory_addr[1]), 
            .Z(n19_adj_906)) /* synthesis lut_function=(A (B+!(C))+!A (B (C))) */ ;   // c:/lscc/ep16vhdl/uart16.vhd(37[3:9])
    defparam i7212_3_lut.init = 16'hcaca;
    ORCALUT4 i29_3_lut_adj_209 (.A(gpio_out[6]), .B(gpio_dir[6]), .C(n8622), 
            .Z(n30)) /* synthesis lut_function=(A (B+!(C))+!A (B (C))) */ ;   // c:/lscc/ep16vhdl/ep16_chip.vhd(124[9:20])
    defparam i29_3_lut_adj_209.init = 16'hcaca;
    ORCALUT4 i15_4_lut_adj_210 (.A(memory_addr[1]), .B(rx_buffer_reg[6]), 
            .C(n8622), .D(baudrate_reg[6]), .Z(n26_adj_907)) /* synthesis lut_function=(A (B (C))+!A !(C+!(D))) */ ;   // c:/lscc/ep16vhdl/ep16_chip.vhd(124[9:20])
    defparam i15_4_lut_adj_210.init = 16'h8580;
    L6MUX21 i7054 (.D0(n7716), .D1(n7717), .SD(rp1[3]), .Z(n1419));
    L6MUX21 i7069 (.D0(n7731), .D1(n7732), .SD(rp[3]), .Z(n7733));
    ORCALUT4 i7003_3_lut (.A(n1226), .B(n1231), .C(sp1[0]), .Z(n7667)) /* synthesis lut_function=(A (B+!(C))+!A (B (C))) */ ;
    defparam i7003_3_lut.init = 16'hcaca;
    L6MUX21 i7017 (.D0(n7679), .D1(n7680), .SD(sp1[3]), .Z(n1304));
    BB ioport_pad_14 (.I(gpio_out[14]), .T(n1855), .B(ioport[14]), .O(ioport_out_14));   // c:/lscc/ep16vhdl/ep16_chip.vhd(44[2:8])
    BB ioport_pad_13 (.I(gpio_out[13]), .T(n1857), .B(ioport[13]), .O(ioport_out_13));   // c:/lscc/ep16vhdl/ep16_chip.vhd(44[2:8])
    BB ioport_pad_12 (.I(gpio_out[12]), .T(n1859), .B(ioport[12]), .O(ioport_out_12));   // c:/lscc/ep16vhdl/ep16_chip.vhd(44[2:8])
    BB ioport_pad_11 (.I(gpio_out[11]), .T(n1861), .B(ioport[11]), .O(ioport_out_11));   // c:/lscc/ep16vhdl/ep16_chip.vhd(44[2:8])
    BB ioport_pad_10 (.I(gpio_out[10]), .T(n1863), .B(ioport[10]), .O(ioport_out_10));   // c:/lscc/ep16vhdl/ep16_chip.vhd(44[2:8])
    BB ioport_pad_9 (.I(gpio_out[9]), .T(n1865), .B(ioport[9]), .O(ioport_out_9));   // c:/lscc/ep16vhdl/ep16_chip.vhd(44[2:8])
    BB ioport_pad_8 (.I(gpio_out[8]), .T(n1867), .B(ioport[8]), .O(ioport_out_8));   // c:/lscc/ep16vhdl/ep16_chip.vhd(44[2:8])
    BB ioport_pad_7 (.I(gpio_out[7]), .T(n1869), .B(ioport[7]), .O(ioport_out_7));   // c:/lscc/ep16vhdl/ep16_chip.vhd(44[2:8])
    BB ioport_pad_6 (.I(gpio_out[6]), .T(n1871), .B(ioport[6]), .O(ioport_out_6));   // c:/lscc/ep16vhdl/ep16_chip.vhd(44[2:8])
    BB ioport_pad_5 (.I(gpio_out[5]), .T(n1873), .B(ioport[5]), .O(ioport_out_5));   // c:/lscc/ep16vhdl/ep16_chip.vhd(44[2:8])
    BB ioport_pad_4 (.I(gpio_out[4]), .T(n1875), .B(ioport[4]), .O(ioport_out_4));   // c:/lscc/ep16vhdl/ep16_chip.vhd(44[2:8])
    BB ioport_pad_3 (.I(gpio_out[3]), .T(n1877), .B(ioport[3]), .O(ioport_out_3));   // c:/lscc/ep16vhdl/ep16_chip.vhd(44[2:8])
    BB ioport_pad_2 (.I(gpio_out[2]), .T(n1879), .B(ioport[2]), .O(ioport_out_2));   // c:/lscc/ep16vhdl/ep16_chip.vhd(44[2:8])
    BB ioport_pad_1 (.I(gpio_out[1]), .T(n1881), .B(ioport[1]), .O(ioport_out_1));   // c:/lscc/ep16vhdl/ep16_chip.vhd(44[2:8])
    BB ioport_pad_0 (.I(gpio_out[0]), .T(n1883), .B(ioport[0]), .O(ioport_out_0));   // c:/lscc/ep16vhdl/ep16_chip.vhd(44[2:8])
    OB uart_o_pad (.I(uart_o_c), .O(uart_o));   // c:/lscc/ep16vhdl/ep16_chip.vhd(41[2:8])
    OB acknowledge_o_pad (.I(acknowledge_o_c), .O(acknowledge_o));   // c:/lscc/ep16vhdl/ep16_chip.vhd(42[2:15])
    IB aclk_pad (.I(aclk), .O(aclk_c));   // c:/lscc/ep16vhdl/ep16_chip.vhd(36[2:6])
    IB arst_pad (.I(arst), .O(arst_c));   // c:/lscc/ep16vhdl/ep16_chip.vhd(37[2:6])
    IB interrupt_i_pad_4 (.I(interrupt_i[4]), .O(interrupt_i_c_4));   // c:/lscc/ep16vhdl/ep16_chip.vhd(38[2:13])
    IB interrupt_i_pad_3 (.I(interrupt_i[3]), .O(interrupt_i_c_3));   // c:/lscc/ep16vhdl/ep16_chip.vhd(38[2:13])
    IB interrupt_i_pad_2 (.I(interrupt_i[2]), .O(interrupt_i_c_2));   // c:/lscc/ep16vhdl/ep16_chip.vhd(38[2:13])
    IB interrupt_i_pad_1 (.I(interrupt_i[1]), .O(interrupt_i_c_1));   // c:/lscc/ep16vhdl/ep16_chip.vhd(38[2:13])
    IB interrupt_i_pad_0 (.I(interrupt_i[0]), .O(interrupt_i_c_0));   // c:/lscc/ep16vhdl/ep16_chip.vhd(38[2:13])
    IB uart_i_pad (.I(uart_i), .O(uart_i_c));   // c:/lscc/ep16vhdl/ep16_chip.vhd(39[2:8])
    ORCALUT4 i3249_4_lut_then_4_lut (.A(baudrate_reg[0]), .B(n81), .C(rx_irq_o_N_643), 
            .D(n8660), .Z(n8699)) /* synthesis lut_function=(A (B (C+(D))+!B !(C+!(D)))+!A (B (C))) */ ;   // c:/lscc/ep16vhdl/uart16.vhd(39[3:11])
    defparam i3249_4_lut_then_4_lut.init = 16'hcac0;
    ORCALUT4 i3249_4_lut_else_4_lut (.A(baudrate_reg[1]), .B(rxd_ff), .Z(n8698)) /* synthesis lut_function=(!((B)+!A)) */ ;   // c:/lscc/ep16vhdl/uart16.vhd(39[3:11])
    defparam i3249_4_lut_else_4_lut.init = 16'h2222;
    ORCALUT4 equal_762_i5_2_lut_rep_281 (.A(rp1[0]), .B(rp1[1]), .Z(n8661)) /* synthesis lut_function=((B)+!A) */ ;   // c:/lscc/ep16vhdl/ep16.vhd(47[17:24])
    defparam equal_762_i5_2_lut_rep_281.init = 16'hdddd;
    L6MUX21 i7030 (.D0(n7690), .D1(n7691), .SD(sp[2]), .Z(n7694));
    FD1P3AX creset_728 (.D(n7570), .SP(aclk_c_enable_78), .CK(aclk_c), 
            .Q(n1356));   // c:/lscc/ep16vhdl/ep16.vhd(47[17:24])
    defparam creset_728.GSR = "ENABLED";
    L6MUX21 i7031 (.D0(n7692), .D1(n7693), .SD(sp[2]), .Z(n7695));
    L6MUX21 i7052 (.D0(n7712), .D1(n7713), .SD(rp1[2]), .Z(n7716));
    ORCALUT4 i7004_3_lut (.A(n1236), .B(n1241), .C(sp1[0]), .Z(n7668)) /* synthesis lut_function=(A (B+!(C))+!A (B (C))) */ ;
    defparam i7004_3_lut.init = 16'hcaca;
    ORCALUT4 i6877_4_lut_4_lut (.A(rp1[0]), .B(rp1[1]), .C(n7105), .D(n1346), 
            .Z(n7541)) /* synthesis lut_function=(A (B (D)+!B (C+(D)))+!A (D)) */ ;   // c:/lscc/ep16vhdl/ep16.vhd(47[17:24])
    defparam i6877_4_lut_4_lut.init = 16'hff20;
    ORCALUT4 i1_4_lut_adj_211 (.A(n7407), .B(n8602), .C(n7027), .D(n8616), 
            .Z(aclk_c_enable_123)) /* synthesis lut_function=(!(A+(((D)+!C)+!B))) */ ;
    defparam i1_4_lut_adj_211.init = 16'h0040;
    ORCALUT4 i8_3_lut (.A(i[0]), .B(n3_adj_914), .C(p_sel[1]), .Z(n4)) /* synthesis lut_function=(A (B+!(C))+!A (B (C))) */ ;   // c:/lscc/ep16vhdl/ep16.vhd(55[9:14])
    defparam i8_3_lut.init = 16'hcaca;
    ORCALUT4 m1_lut (.Z(n9433)) /* synthesis lut_function=1, syn_instantiated=1 */ ;
    defparam m1_lut.init = 16'hffff;
    GSR GSR_INST (.GSR(arst_c));
    L6MUX21 i7053 (.D0(n7714), .D1(n7715), .SD(rp1[2]), .Z(n7717));
    ORCALUT4 equal_718_i5_2_lut_rep_283 (.A(rp1[0]), .B(rp1[1]), .Z(n8663)) /* synthesis lut_function=(A+!(B)) */ ;   // c:/lscc/ep16vhdl/ep16.vhd(47[17:24])
    defparam equal_718_i5_2_lut_rep_283.init = 16'hbbbb;
    ORCALUT4 i6876_4_lut_4_lut (.A(rp1[0]), .B(rp1[1]), .C(n7105), .D(n1351), 
            .Z(n7540)) /* synthesis lut_function=(A (D)+!A (B (C+(D))+!B (D))) */ ;   // c:/lscc/ep16vhdl/ep16.vhd(47[17:24])
    defparam i6876_4_lut_4_lut.init = 16'hff40;
    ORCALUT4 Mux_707_i1_3_lut_rep_284 (.A(n1314), .B(n1317), .C(sp[4]), 
            .Z(n8664)) /* synthesis lut_function=(A (B+!(C))+!A (B (C))) */ ;   // c:/lscc/ep16vhdl/ep16.vhd(47[9:16])
    defparam Mux_707_i1_3_lut_rep_284.init = 16'hcaca;
    ORCALUT4 i709_2_lut_rep_260_4_lut (.A(n1314), .B(n1317), .C(sp[4]), 
            .D(n1305), .Z(n8640)) /* synthesis lut_function=(A (B (D)+!B !(C+!(D)))+!A (B (C (D)))) */ ;   // c:/lscc/ep16vhdl/ep16.vhd(47[9:16])
    defparam i709_2_lut_rep_260_4_lut.init = 16'hca00;
    ORCALUT4 i3427_2_lut_rep_286 (.A(rp1[0]), .B(rp1[1]), .Z(n8666)) /* synthesis lut_function=(A (B)) */ ;
    defparam i3427_2_lut_rep_286.init = 16'h8888;
    L6MUX21 i7067 (.D0(n7727), .D1(n7728), .SD(rp[2]), .Z(n7731));
    ORCALUT4 i7018_3_lut (.A(n1226), .B(n1231), .C(sp[0]), .Z(n7682)) /* synthesis lut_function=(A (B+!(C))+!A (B (C))) */ ;
    defparam i7018_3_lut.init = 16'hcaca;
    ORCALUT4 i7019_3_lut (.A(n1236), .B(n1241), .C(sp[0]), .Z(n7683)) /* synthesis lut_function=(A (B+!(C))+!A (B (C))) */ ;
    defparam i7019_3_lut.init = 16'hcaca;
    ORCALUT4 i7020_3_lut (.A(n1246), .B(n1251), .C(sp[0]), .Z(n7684)) /* synthesis lut_function=(A (B+!(C))+!A (B (C))) */ ;
    defparam i7020_3_lut.init = 16'hcaca;
    ORCALUT4 i7021_3_lut (.A(n1256), .B(n1261), .C(sp[0]), .Z(n7685)) /* synthesis lut_function=(A (B+!(C))+!A (B (C))) */ ;
    defparam i7021_3_lut.init = 16'hcaca;
    ORCALUT4 i7022_3_lut (.A(n1266), .B(n1271), .C(sp[0]), .Z(n7686)) /* synthesis lut_function=(A (B+!(C))+!A (B (C))) */ ;
    defparam i7022_3_lut.init = 16'hcaca;
    ORCALUT4 i7023_3_lut (.A(n1276), .B(n1281), .C(sp[0]), .Z(n7687)) /* synthesis lut_function=(A (B+!(C))+!A (B (C))) */ ;
    defparam i7023_3_lut.init = 16'hcaca;
    ORCALUT4 i7024_3_lut (.A(n1286), .B(n1291), .C(sp[0]), .Z(n7688)) /* synthesis lut_function=(A (B+!(C))+!A (B (C))) */ ;
    defparam i7024_3_lut.init = 16'hcaca;
    ORCALUT4 equal_638_i5_2_lut_rep_287 (.A(sp1[0]), .B(sp1[1]), .Z(n8667)) /* synthesis lut_function=(A+!(B)) */ ;   // c:/lscc/ep16vhdl/ep16.vhd(47[9:16])
    defparam equal_638_i5_2_lut_rep_287.init = 16'hbbbb;
    ORCALUT4 i1187_4_lut (.A(system_data_o_15__N_16), .B(system_data_o_15__N_51), 
            .C(memory_data_i[11]), .D(system_write), .Z(system_data_o[11])) /* synthesis lut_function=(A (B (C+!(D)))+!A (B (C (D)))) */ ;   // c:/lscc/ep16vhdl/ep16_chip.vhd(198[2:15])
    defparam i1187_4_lut.init = 16'hc088;
    ORCALUT4 i7025_3_lut (.A(n1296), .B(n1301), .C(sp[0]), .Z(n7689)) /* synthesis lut_function=(A (B+!(C))+!A (B (C))) */ ;
    defparam i7025_3_lut.init = 16'hcaca;
    L6MUX21 i7068 (.D0(n7729), .D1(n7730), .SD(rp[2]), .Z(n7732));
    L6MUX21 i7015 (.D0(n7675), .D1(n7676), .SD(sp1[2]), .Z(n7679));
    ORCALUT4 mux_470_i12_4_lut (.A(memory_data_o[11]), .B(n1095), .C(n8618), 
            .D(n6537), .Z(system_data_o_15__N_16)) /* synthesis lut_function=(A (B+!(C (D)))+!A (B (C)+!B !((D)+!C))) */ ;   // c:/lscc/ep16vhdl/uart16.vhd(80[2] 95[9])
    defparam mux_470_i12_4_lut.init = 16'hcafa;
    L6MUX21 i7016 (.D0(n7677), .D1(n7678), .SD(sp1[2]), .Z(n7680));
    ORCALUT4 i6888_3_lut_3_lut (.A(sp1[0]), .B(sp1[1]), .C(n1296), .Z(n7552)) /* synthesis lut_function=(A (C)+!A (B+(C))) */ ;   // c:/lscc/ep16vhdl/ep16.vhd(47[9:16])
    defparam i6888_3_lut_3_lut.init = 16'hf4f4;
    ORCALUT4 i1_2_lut_rep_288 (.A(sp1[0]), .B(sp1[1]), .Z(n8668)) /* synthesis lut_function=(A (B)) */ ;
    defparam i1_2_lut_rep_288.init = 16'h8888;
    ORCALUT4 i6875_3_lut_3_lut (.A(sp1[0]), .B(sp1[1]), .C(n1301), .Z(n7539)) /* synthesis lut_function=(A (B+(C))+!A (C)) */ ;
    defparam i6875_3_lut_3_lut.init = 16'hf8f8;
    ORCALUT4 i1_2_lut_rep_214_3_lut_4_lut (.A(sp1[0]), .B(sp1[1]), .C(arst_c), 
            .D(n8614), .Z(aclk_c_enable_18)) /* synthesis lut_function=(A (B (C (D)))) */ ;
    defparam i1_2_lut_rep_214_3_lut_4_lut.init = 16'h8000;
    ORCALUT4 i1186_4_lut (.A(system_data_o_15__N_19), .B(system_data_o_15__N_51), 
            .C(memory_data_i[10]), .D(system_write), .Z(system_data_o[10])) /* synthesis lut_function=(A (B (C+!(D)))+!A (B (C (D)))) */ ;   // c:/lscc/ep16vhdl/ep16_chip.vhd(198[2:15])
    defparam i1186_4_lut.init = 16'hc088;
    PFUMX i7026 (.BLUT(n7682), .ALUT(n7683), .C0(sp[1]), .Z(n7690));
    ORCALUT4 mux_470_i11_4_lut (.A(memory_data_o[10]), .B(n1094), .C(n8618), 
            .D(n6537), .Z(system_data_o_15__N_19)) /* synthesis lut_function=(A (B+!(C (D)))+!A (B (C)+!B !((D)+!C))) */ ;   // c:/lscc/ep16vhdl/uart16.vhd(80[2] 95[9])
    defparam mux_470_i11_4_lut.init = 16'hcafa;
    ORCALUT4 equal_678_i5_2_lut_rep_291 (.A(sp1[0]), .B(sp1[1]), .Z(n8671)) /* synthesis lut_function=(A+(B)) */ ;   // c:/lscc/ep16vhdl/ep16.vhd(47[9:16])
    defparam equal_678_i5_2_lut_rep_291.init = 16'heeee;
    ORCALUT4 i6880_3_lut_3_lut (.A(sp1[0]), .B(sp1[1]), .C(n1286), .Z(n7544)) /* synthesis lut_function=(A (C)+!A ((C)+!B)) */ ;   // c:/lscc/ep16vhdl/ep16.vhd(47[9:16])
    defparam i6880_3_lut_3_lut.init = 16'hf1f1;
    ORCALUT4 i872_3_lut_rep_219_4_lut (.A(sp1[0]), .B(sp1[1]), .C(n963), 
            .D(n6010), .Z(n8599)) /* synthesis lut_function=(A (C+(D))+!A (B (C+(D))+!B (D))) */ ;   // c:/lscc/ep16vhdl/ep16.vhd(47[9:16])
    defparam i872_3_lut_rep_219_4_lut.init = 16'hffe0;
    PFUMX i7027 (.BLUT(n7684), .ALUT(n7685), .C0(sp[1]), .Z(n7691));
    ORCALUT4 i1_4_lut_adj_212 (.A(n7043), .B(memory_addr[5]), .C(n8601), 
            .D(n6835), .Z(n6537)) /* synthesis lut_function=(!(A+(B+(C+!(D))))) */ ;
    defparam i1_4_lut_adj_212.init = 16'h0100;
    ORCALUT4 i1_2_lut (.A(n18), .B(system_read), .Z(n6833)) /* synthesis lut_function=(A (B)) */ ;
    defparam i1_2_lut.init = 16'h8888;
    PFUMX i7028 (.BLUT(n7686), .ALUT(n7687), .C0(sp[1]), .Z(n7692));
    ORCALUT4 i7040_3_lut (.A(n1341), .B(n1346), .C(rp1[0]), .Z(n7704)) /* synthesis lut_function=(A (B+!(C))+!A (B (C))) */ ;
    defparam i7040_3_lut.init = 16'hcaca;
    ORCALUT4 i1185_4_lut (.A(system_data_o_15__N_22), .B(system_data_o_15__N_51), 
            .C(memory_data_i[9]), .D(system_write), .Z(system_data_o[9])) /* synthesis lut_function=(A (B (C+!(D)))+!A (B (C (D)))) */ ;   // c:/lscc/ep16vhdl/ep16_chip.vhd(198[2:15])
    defparam i1185_4_lut.init = 16'hc088;
    ORCALUT4 i7041_3_lut (.A(n1351), .B(n1356), .C(rp1[0]), .Z(n7705)) /* synthesis lut_function=(A (B+!(C))+!A (B (C))) */ ;
    defparam i7041_3_lut.init = 16'hcaca;
    ORCALUT4 i7042_3_lut (.A(n1361), .B(n1366), .C(rp1[0]), .Z(n7706)) /* synthesis lut_function=(A (B+!(C))+!A (B (C))) */ ;
    defparam i7042_3_lut.init = 16'hcaca;
    ORCALUT4 i7043_3_lut (.A(n1371), .B(n1376), .C(rp1[0]), .Z(n7707)) /* synthesis lut_function=(A (B+!(C))+!A (B (C))) */ ;
    defparam i7043_3_lut.init = 16'hcaca;
    ORCALUT4 equal_682_i5_2_lut_rep_293 (.A(sp1[0]), .B(sp1[1]), .Z(n8673)) /* synthesis lut_function=((B)+!A) */ ;   // c:/lscc/ep16vhdl/ep16.vhd(47[9:16])
    defparam equal_682_i5_2_lut_rep_293.init = 16'hdddd;
    ORCALUT4 mux_470_i10_4_lut (.A(memory_data_o[9]), .B(n1093), .C(n8618), 
            .D(n6537), .Z(system_data_o_15__N_22)) /* synthesis lut_function=(A (B+!(C (D)))+!A (B (C)+!B !((D)+!C))) */ ;   // c:/lscc/ep16vhdl/uart16.vhd(80[2] 95[9])
    defparam mux_470_i10_4_lut.init = 16'hcafa;
    ORCALUT4 i1184_4_lut (.A(system_data_o_15__N_25), .B(system_data_o_15__N_51), 
            .C(memory_data_i[8]), .D(system_write), .Z(system_data_o[8])) /* synthesis lut_function=(A (B (C+!(D)))+!A (B (C (D)))) */ ;   // c:/lscc/ep16vhdl/ep16_chip.vhd(198[2:15])
    defparam i1184_4_lut.init = 16'hc088;
    ORCALUT4 mux_470_i9_4_lut (.A(memory_data_o[8]), .B(n8245), .C(n8618), 
            .D(n6537), .Z(system_data_o_15__N_25)) /* synthesis lut_function=(A (B+!(C (D)))+!A (B (C)+!B !((D)+!C))) */ ;   // c:/lscc/ep16vhdl/uart16.vhd(80[2] 95[9])
    defparam mux_470_i9_4_lut.init = 16'hcafa;
    ORCALUT4 i1183_4_lut (.A(system_data_o_15__N_28), .B(system_data_o_15__N_51), 
            .C(memory_data_i[7]), .D(system_write), .Z(system_data_o[7])) /* synthesis lut_function=(A (B (C+!(D)))+!A (B (C (D)))) */ ;   // c:/lscc/ep16vhdl/ep16_chip.vhd(198[2:15])
    defparam i1183_4_lut.init = 16'hc088;
    ORCALUT4 mux_470_i8_4_lut (.A(memory_data_o[7]), .B(n1091), .C(n8618), 
            .D(n6537), .Z(system_data_o_15__N_28)) /* synthesis lut_function=(A (B+!(C (D)))+!A (B (C)+!B !((D)+!C))) */ ;   // c:/lscc/ep16vhdl/uart16.vhd(80[2] 95[9])
    defparam mux_470_i8_4_lut.init = 16'hcafa;
    PFUMX i7029 (.BLUT(n7688), .ALUT(n7689), .C0(sp[1]), .Z(n7693));
    ORCALUT4 i1_2_lut_rep_215_3_lut_4_lut (.A(sp1[0]), .B(sp1[1]), .C(arst_c), 
            .D(n8614), .Z(aclk_c_enable_15)) /* synthesis lut_function=(!((B+!(C (D)))+!A)) */ ;   // c:/lscc/ep16vhdl/ep16.vhd(47[9:16])
    defparam i1_2_lut_rep_215_3_lut_4_lut.init = 16'h2000;
    ORCALUT4 i6879_3_lut_3_lut (.A(sp1[0]), .B(sp1[1]), .C(n1291), .Z(n7543)) /* synthesis lut_function=(A ((C)+!B)+!A (C)) */ ;   // c:/lscc/ep16vhdl/ep16.vhd(47[9:16])
    defparam i6879_3_lut_3_lut.init = 16'hf2f2;
    PFUMX i7048 (.BLUT(n7704), .ALUT(n7705), .C0(rp1[1]), .Z(n7712));
    ORCALUT4 equal_758_i5_2_lut_rep_295 (.A(rp1[0]), .B(rp1[1]), .Z(n8675)) /* synthesis lut_function=(A+(B)) */ ;   // c:/lscc/ep16vhdl/ep16.vhd(47[17:24])
    defparam equal_758_i5_2_lut_rep_295.init = 16'heeee;
    PFUMX i7049 (.BLUT(n7706), .ALUT(n7707), .C0(rp1[1]), .Z(n7713));
    ORCALUT4 i6878_4_lut_4_lut (.A(rp1[0]), .B(rp1[1]), .C(n7105), .D(n1341), 
            .Z(n7542)) /* synthesis lut_function=(A (D)+!A (B (D)+!B (C+(D)))) */ ;   // c:/lscc/ep16vhdl/ep16.vhd(47[17:24])
    defparam i6878_4_lut_4_lut.init = 16'hff10;
    PFUMX i7050 (.BLUT(n7708), .ALUT(n7709), .C0(rp1[1]), .Z(n7714));
    PFUMX i7051 (.BLUT(n7710), .ALUT(n7711), .C0(rp1[1]), .Z(n7715));
    PFUMX i7063 (.BLUT(n7719), .ALUT(n7720), .C0(rp[1]), .Z(n7727));
    PFUMX i7064 (.BLUT(n7721), .ALUT(n7722), .C0(rp[1]), .Z(n7728));
    PFUMX i7065 (.BLUT(n7723), .ALUT(n7724), .C0(rp[1]), .Z(n7729));
    PFUMX i7066 (.BLUT(n7725), .ALUT(n7726), .C0(rp[1]), .Z(n7730));
    PFUMX i6 (.BLUT(n1), .ALUT(n1_adj_912), .C0(slot[1]), .Z(n3));
    ORCALUT4 i7340_2_lut_rep_299 (.A(sp1[2]), .B(sp1[3]), .Z(aclk_c_enable_29)) /* synthesis lut_function=(!((B)+!A)) */ ;   // c:/lscc/ep16vhdl/ep16.vhd(47[9:16])
    defparam i7340_2_lut_rep_299.init = 16'h2222;
    ORCALUT4 i6890_3_lut_3_lut (.A(sp1[2]), .B(sp1[3]), .C(n1261), .Z(n7554)) /* synthesis lut_function=(A ((C)+!B)+!A (C)) */ ;   // c:/lscc/ep16vhdl/ep16.vhd(47[9:16])
    defparam i6890_3_lut_3_lut.init = 16'hf2f2;
    ORCALUT4 i6887_3_lut_3_lut (.A(sp1[2]), .B(sp1[3]), .C(n1251), .Z(n7551)) /* synthesis lut_function=(A ((C)+!B)+!A (C)) */ ;   // c:/lscc/ep16vhdl/ep16.vhd(47[9:16])
    defparam i6887_3_lut_3_lut.init = 16'hf2f2;
    ORCALUT4 i7044_3_lut (.A(n1381), .B(n1386), .C(rp1[0]), .Z(n7708)) /* synthesis lut_function=(A (B+!(C))+!A (B (C))) */ ;
    defparam i7044_3_lut.init = 16'hcaca;
    ORCALUT4 i3522_2_lut_rep_239_3_lut (.A(n8664), .B(n1305), .C(n1328), 
            .Z(n8619)) /* synthesis lut_function=(A (B (C))) */ ;   // c:/lscc/ep16vhdl/ep16.vhd(47[9:16])
    defparam i3522_2_lut_rep_239_3_lut.init = 16'h8080;
    ORCALUT4 i3524_2_lut_rep_240_3_lut (.A(n8664), .B(n1305), .C(n1326), 
            .Z(n8620)) /* synthesis lut_function=(A (B (C))) */ ;   // c:/lscc/ep16vhdl/ep16.vhd(47[9:16])
    defparam i3524_2_lut_rep_240_3_lut.init = 16'h8080;
    ORCALUT4 i1_2_lut_rep_243_3_lut (.A(n8664), .B(n1305), .C(n1321), 
            .Z(n8623)) /* synthesis lut_function=(A (B (C))) */ ;   // c:/lscc/ep16vhdl/ep16.vhd(47[9:16])
    defparam i1_2_lut_rep_243_3_lut.init = 16'h8080;
    ORCALUT4 i1_2_lut_adj_213 (.A(p[10]), .B(p[8]), .Z(n6901)) /* synthesis lut_function=(A (B)) */ ;
    defparam i1_2_lut_adj_213.init = 16'h8888;
    ORCALUT4 i1_4_lut_adj_214 (.A(a[11]), .B(n6893), .C(n6891), .D(a[13]), 
            .Z(n6655)) /* synthesis lut_function=(A (B (C (D)))) */ ;
    defparam i1_4_lut_adj_214.init = 16'h8000;
    ORCALUT4 i1181_4_lut (.A(system_data_o_15__N_34), .B(system_data_o_15__N_51), 
            .C(memory_data_i[5]), .D(system_write), .Z(system_data_o[5])) /* synthesis lut_function=(A (B (C+!(D)))+!A (B (C (D)))) */ ;   // c:/lscc/ep16vhdl/ep16_chip.vhd(198[2:15])
    defparam i1181_4_lut.init = 16'hc088;
    ORCALUT4 i1_3_lut (.A(a[12]), .B(a[9]), .C(a[14]), .Z(n6893)) /* synthesis lut_function=(A (B (C))) */ ;
    defparam i1_3_lut.init = 16'h8080;
    ORCALUT4 i18_4_lut (.A(memory_data_o[5]), .B(n6537), .C(n8618), .D(n28_adj_913), 
            .Z(system_data_o_15__N_34)) /* synthesis lut_function=(A (((D)+!C)+!B)+!A (B (C (D))+!B (C))) */ ;   // c:/lscc/ep16vhdl/uart16.vhd(37[3:9])
    defparam i18_4_lut.init = 16'hfa3a;
    ORCALUT4 i7045_3_lut (.A(n1391), .B(n1396), .C(rp1[0]), .Z(n7709)) /* synthesis lut_function=(A (B+!(C))+!A (B (C))) */ ;
    defparam i7045_3_lut.init = 16'hcaca;
    ORCALUT4 i7046_3_lut (.A(n1401), .B(n1406), .C(rp1[0]), .Z(n7710)) /* synthesis lut_function=(A (B+!(C))+!A (B (C))) */ ;
    defparam i7046_3_lut.init = 16'hcaca;
    ORCALUT4 i1180_4_lut (.A(system_data_o_15__N_37), .B(system_data_o_15__N_51), 
            .C(memory_data_i[4]), .D(system_write), .Z(system_data_o[4])) /* synthesis lut_function=(A (B (C+!(D)))+!A (B (C (D)))) */ ;   // c:/lscc/ep16vhdl/ep16_chip.vhd(198[2:15])
    defparam i1180_4_lut.init = 16'hc088;
    ORCALUT4 i1176_4_lut (.A(system_data_o_15__N_49), .B(system_data_o_15__N_51), 
            .C(memory_data_i[0]), .D(system_write), .Z(system_data_o[0])) /* synthesis lut_function=(A (B (C+!(D)))+!A (B (C (D)))) */ ;   // c:/lscc/ep16vhdl/ep16_chip.vhd(198[2:15])
    defparam i1176_4_lut.init = 16'hc088;
    ORCALUT4 mux_470_i1_4_lut (.A(memory_data_o[0]), .B(n1084), .C(n8618), 
            .D(n6537), .Z(system_data_o_15__N_49)) /* synthesis lut_function=(A (B+!(C (D)))+!A (B (C)+!B !((D)+!C))) */ ;   // c:/lscc/ep16vhdl/uart16.vhd(80[2] 95[9])
    defparam mux_470_i1_4_lut.init = 16'hcafa;
    ORCALUT4 i18_4_lut_adj_215 (.A(memory_data_o[4]), .B(n6537), .C(n8618), 
            .D(n28_adj_918), .Z(system_data_o_15__N_37)) /* synthesis lut_function=(A (((D)+!C)+!B)+!A (B (C (D))+!B (C))) */ ;   // c:/lscc/ep16vhdl/uart16.vhd(37[3:9])
    defparam i18_4_lut_adj_215.init = 16'hfa3a;
    ORCALUT4 i7047_3_lut (.A(n1411), .B(n1416), .C(rp1[0]), .Z(n7711)) /* synthesis lut_function=(A (B+!(C))+!A (B (C))) */ ;
    defparam i7047_3_lut.init = 16'hcaca;
    ORCALUT4 i7055_3_lut (.A(n1341), .B(n1346), .C(rp[0]), .Z(n7719)) /* synthesis lut_function=(A (B+!(C))+!A (B (C))) */ ;
    defparam i7055_3_lut.init = 16'hcaca;
    ORCALUT4 mux_595_i15_3_lut (.A(gpio_out[14]), .B(baudrate_reg[14]), 
            .C(data_o_15__N_441), .Z(n1164)) /* synthesis lut_function=(A (B+!(C))+!A (B (C))) */ ;   // c:/lscc/ep16vhdl/uart16.vhd(80[2] 95[9])
    defparam mux_595_i15_3_lut.init = 16'hcaca;
    ORCALUT4 i3521_2_lut_rep_244_3_lut (.A(n8664), .B(n1305), .C(n1329), 
            .Z(n8624)) /* synthesis lut_function=(A (B (C))) */ ;   // c:/lscc/ep16vhdl/ep16.vhd(47[9:16])
    defparam i3521_2_lut_rep_244_3_lut.init = 16'h8080;
    ORCALUT4 i3520_2_lut_rep_245_3_lut (.A(n8664), .B(n1305), .C(n1330), 
            .Z(n8625)) /* synthesis lut_function=(A (B (C))) */ ;   // c:/lscc/ep16vhdl/ep16.vhd(47[9:16])
    defparam i3520_2_lut_rep_245_3_lut.init = 16'h8080;
    PFUMX i3148 (.BLUT(n5), .ALUT(n6), .C0(n7595), .Z(p_in[5]));
    ORCALUT4 i3518_2_lut_rep_247_3_lut (.A(n8664), .B(n1305), .C(n1332), 
            .Z(n8627)) /* synthesis lut_function=(A (B (C))) */ ;   // c:/lscc/ep16vhdl/ep16.vhd(47[9:16])
    defparam i3518_2_lut_rep_247_3_lut.init = 16'h8080;
    ORCALUT4 i1_3_lut_adj_216 (.A(n8618), .B(n1996), .C(system_write), 
            .Z(system_data_o_15__N_51)) /* synthesis lut_function=((B+(C))+!A) */ ;   // c:/lscc/ep16vhdl/ep16_chip.vhd(198[20] 205[23])
    defparam i1_3_lut_adj_216.init = 16'hfdfd;
    ORCALUT4 i3515_2_lut_rep_251_3_lut (.A(n8664), .B(n1305), .C(n1335), 
            .Z(n8631)) /* synthesis lut_function=(A (B (C))) */ ;   // c:/lscc/ep16vhdl/ep16.vhd(47[9:16])
    defparam i3515_2_lut_rep_251_3_lut.init = 16'h8080;
    ORCALUT4 i7056_3_lut (.A(n1351), .B(n1356), .C(rp[0]), .Z(n7720)) /* synthesis lut_function=(A (B+!(C))+!A (B (C))) */ ;
    defparam i7056_3_lut.init = 16'hcaca;
    ORCALUT4 i7057_3_lut (.A(n1361), .B(n1366), .C(rp[0]), .Z(n7721)) /* synthesis lut_function=(A (B+!(C))+!A (B (C))) */ ;
    defparam i7057_3_lut.init = 16'hcaca;
    ORCALUT4 i3526_2_lut_rep_254_3_lut (.A(n8664), .B(n1305), .C(n1324), 
            .Z(n8634)) /* synthesis lut_function=(A (B (C))) */ ;   // c:/lscc/ep16vhdl/ep16.vhd(47[9:16])
    defparam i3526_2_lut_rep_254_3_lut.init = 16'h8080;
    ORCALUT4 i7058_3_lut (.A(n1371), .B(n1376), .C(rp[0]), .Z(n7722)) /* synthesis lut_function=(A (B+!(C))+!A (B (C))) */ ;
    defparam i7058_3_lut.init = 16'hcaca;
    ORCALUT4 i7005_3_lut (.A(n1246), .B(n1251), .C(sp1[0]), .Z(n7669)) /* synthesis lut_function=(A (B+!(C))+!A (B (C))) */ ;
    defparam i7005_3_lut.init = 16'hcaca;
    ORCALUT4 i7006_3_lut (.A(n1256), .B(n1261), .C(sp1[0]), .Z(n7670)) /* synthesis lut_function=(A (B+!(C))+!A (B (C))) */ ;
    defparam i7006_3_lut.init = 16'hcaca;
    ORCALUT4 i1179_4_lut (.A(system_data_o_15__N_40), .B(system_data_o_15__N_51), 
            .C(memory_data_i[3]), .D(system_write), .Z(system_data_o[3])) /* synthesis lut_function=(A (B (C+!(D)))+!A (B (C (D)))) */ ;   // c:/lscc/ep16vhdl/ep16_chip.vhd(198[2:15])
    defparam i1179_4_lut.init = 16'hc088;
    ORCALUT4 mux_595_i14_3_lut (.A(gpio_out[13]), .B(baudrate_reg[13]), 
            .C(data_o_15__N_441), .Z(n1165)) /* synthesis lut_function=(A (B+!(C))+!A (B (C))) */ ;   // c:/lscc/ep16vhdl/uart16.vhd(80[2] 95[9])
    defparam mux_595_i14_3_lut.init = 16'hcaca;
    ORCALUT4 i18_4_lut_adj_217 (.A(memory_data_o[3]), .B(n6537), .C(n8618), 
            .D(n28_adj_922), .Z(system_data_o_15__N_40)) /* synthesis lut_function=(A (((D)+!C)+!B)+!A (B (C (D))+!B (C))) */ ;   // c:/lscc/ep16vhdl/uart16.vhd(37[3:9])
    defparam i18_4_lut_adj_217.init = 16'hfa3a;
    ORCALUT4 i7059_3_lut (.A(n1381), .B(n1386), .C(rp[0]), .Z(n7723)) /* synthesis lut_function=(A (B+!(C))+!A (B (C))) */ ;
    defparam i7059_3_lut.init = 16'hcaca;
    ORCALUT4 i7007_3_lut (.A(n1266), .B(n1271), .C(sp1[0]), .Z(n7671)) /* synthesis lut_function=(A (B+!(C))+!A (B (C))) */ ;
    defparam i7007_3_lut.init = 16'hcaca;
    ORCALUT4 i1178_4_lut (.A(system_data_o_15__N_43), .B(system_data_o_15__N_51), 
            .C(memory_data_i[2]), .D(system_write), .Z(system_data_o[2])) /* synthesis lut_function=(A (B (C+!(D)))+!A (B (C (D)))) */ ;   // c:/lscc/ep16vhdl/ep16_chip.vhd(198[2:15])
    defparam i1178_4_lut.init = 16'hc088;
    ORCALUT4 i18_4_lut_adj_218 (.A(memory_data_o[2]), .B(n6537), .C(n8618), 
            .D(n28_adj_926), .Z(system_data_o_15__N_43)) /* synthesis lut_function=(A (((D)+!C)+!B)+!A (B (C (D))+!B (C))) */ ;   // c:/lscc/ep16vhdl/uart16.vhd(37[3:9])
    defparam i18_4_lut_adj_218.init = 16'hfa3a;
    ORCALUT4 i7060_3_lut (.A(n1391), .B(n1396), .C(rp[0]), .Z(n7724)) /* synthesis lut_function=(A (B+!(C))+!A (B (C))) */ ;
    defparam i7060_3_lut.init = 16'hcaca;
    ORCALUT4 i1_2_lut_adj_219 (.A(a[10]), .B(a[8]), .Z(n6891)) /* synthesis lut_function=(A (B)) */ ;
    defparam i1_2_lut_adj_219.init = 16'h8888;
    ORCALUT4 i3517_2_lut_rep_248_3_lut (.A(n8664), .B(n1305), .C(n1333), 
            .Z(n8628)) /* synthesis lut_function=(A (B (C))) */ ;   // c:/lscc/ep16vhdl/ep16.vhd(47[9:16])
    defparam i3517_2_lut_rep_248_3_lut.init = 16'h8080;
    ORCALUT4 i7061_3_lut (.A(n1401), .B(n1406), .C(rp[0]), .Z(n7725)) /* synthesis lut_function=(A (B+!(C))+!A (B (C))) */ ;
    defparam i7061_3_lut.init = 16'hcaca;
    ORCALUT4 i1177_4_lut (.A(system_data_o_15__N_46), .B(system_data_o_15__N_51), 
            .C(memory_data_i[1]), .D(system_write), .Z(system_data_o[1])) /* synthesis lut_function=(A (B (C+!(D)))+!A (B (C (D)))) */ ;   // c:/lscc/ep16vhdl/ep16_chip.vhd(198[2:15])
    defparam i1177_4_lut.init = 16'hc088;
    ORCALUT4 i7008_3_lut (.A(n1276), .B(n1281), .C(sp1[0]), .Z(n7672)) /* synthesis lut_function=(A (B+!(C))+!A (B (C))) */ ;
    defparam i7008_3_lut.init = 16'hcaca;
    ORCALUT4 i7062_3_lut (.A(n1411), .B(n1416), .C(rp[0]), .Z(n7726)) /* synthesis lut_function=(A (B+!(C))+!A (B (C))) */ ;
    defparam i7062_3_lut.init = 16'hcaca;
    ORCALUT4 i1_3_lut_adj_220 (.A(n7411), .B(memory_addr[4]), .C(n7025), 
            .Z(n1996)) /* synthesis lut_function=(!(A+(B+!(C)))) */ ;
    defparam i1_3_lut_adj_220.init = 16'h1010;
    ORCALUT4 i7009_3_lut (.A(n1286), .B(n1291), .C(sp1[0]), .Z(n7673)) /* synthesis lut_function=(A (B+!(C))+!A (B (C))) */ ;
    defparam i7009_3_lut.init = 16'hcaca;
    ORCALUT4 i5_3_lut (.A(i[5]), .B(i[0]), .C(slot[0]), .Z(n1_adj_912)) /* synthesis lut_function=(A (B+!(C))+!A (B (C))) */ ;   // c:/lscc/ep16vhdl/ep16.vhd(48[9:13])
    defparam i5_3_lut.init = 16'hcaca;
    ORCALUT4 i18_4_lut_adj_221 (.A(memory_data_o[1]), .B(n6537), .C(n8618), 
            .D(n28), .Z(system_data_o_15__N_46)) /* synthesis lut_function=(A (((D)+!C)+!B)+!A (B (C (D))+!B (C))) */ ;   // c:/lscc/ep16vhdl/uart16.vhd(37[3:9])
    defparam i18_4_lut_adj_221.init = 16'hfa3a;
    ORCALUT4 i7010_3_lut (.A(n1296), .B(n1301), .C(sp1[0]), .Z(n7674)) /* synthesis lut_function=(A (B+!(C))+!A (B (C))) */ ;
    defparam i7010_3_lut.init = 16'hcaca;
    ORCALUT4 i7332_2_lut (.A(sp1[2]), .B(sp1[3]), .Z(aclk_c_enable_21)) /* synthesis lut_function=(!(A+(B))) */ ;   // c:/lscc/ep16vhdl/ep16.vhd(47[9:16])
    defparam i7332_2_lut.init = 16'h1111;
    PFUMX i7672 (.BLUT(n8698), .ALUT(n8699), .C0(rx_en), .Z(rx_counter_15__N_609[0]));
    ORCALUT4 i3519_2_lut_rep_246_3_lut (.A(n8664), .B(n1305), .C(n1331), 
            .Z(n8626)) /* synthesis lut_function=(A (B (C))) */ ;   // c:/lscc/ep16vhdl/ep16.vhd(47[9:16])
    defparam i3519_2_lut_rep_246_3_lut.init = 16'h8080;
    ORCALUT4 i7342_2_lut (.A(sp1[2]), .B(sp1[3]), .Z(aclk_c_enable_37)) /* synthesis lut_function=(!(A+!(B))) */ ;   // c:/lscc/ep16vhdl/ep16.vhd(47[9:16])
    defparam i7342_2_lut.init = 16'h4444;
    ORCALUT4 i7218_3_lut (.A(n30_adj_919), .B(ioport_out_3), .C(memory_addr[1]), 
            .Z(n19_adj_920)) /* synthesis lut_function=(A (B+!(C))+!A (B (C))) */ ;   // c:/lscc/ep16vhdl/uart16.vhd(37[3:9])
    defparam i7218_3_lut.init = 16'hcaca;
    ORCALUT4 i29_3_lut_adj_222 (.A(gpio_out[3]), .B(gpio_dir[3]), .C(n8622), 
            .Z(n30_adj_919)) /* synthesis lut_function=(A (B+!(C))+!A (B (C))) */ ;   // c:/lscc/ep16vhdl/ep16_chip.vhd(124[9:20])
    defparam i29_3_lut_adj_222.init = 16'hcaca;
    ORCALUT4 i15_4_lut_adj_223 (.A(memory_addr[1]), .B(rx_buffer_reg[3]), 
            .C(n8622), .D(baudrate_reg[3]), .Z(n26_adj_921)) /* synthesis lut_function=(A (B (C))+!A !(C+!(D))) */ ;   // c:/lscc/ep16vhdl/ep16_chip.vhd(124[9:20])
    defparam i15_4_lut_adj_223.init = 16'h8580;
    ORCALUT4 i7216_3_lut (.A(n30_adj_915), .B(ioport_out_4), .C(memory_addr[1]), 
            .Z(n19_adj_916)) /* synthesis lut_function=(A (B+!(C))+!A (B (C))) */ ;   // c:/lscc/ep16vhdl/uart16.vhd(37[3:9])
    defparam i7216_3_lut.init = 16'hcaca;
    ORCALUT4 i29_3_lut_adj_224 (.A(gpio_out[4]), .B(gpio_dir[4]), .C(n8622), 
            .Z(n30_adj_915)) /* synthesis lut_function=(A (B+!(C))+!A (B (C))) */ ;   // c:/lscc/ep16vhdl/ep16_chip.vhd(124[9:20])
    defparam i29_3_lut_adj_224.init = 16'hcaca;
    ORCALUT4 i789_4_lut (.A(n1429), .B(n7733), .C(n1432), .D(rp[4]), 
            .Z(n1435)) /* synthesis lut_function=(A (B (C+!(D)))+!A (B (C (D)))) */ ;   // c:/lscc/ep16vhdl/ep16.vhd(47[17:24])
    defparam i789_4_lut.init = 16'hc088;
    ORCALUT4 i1_3_lut_adj_225 (.A(p[12]), .B(p[9]), .C(p[14]), .Z(n6903)) /* synthesis lut_function=(A (B (C))) */ ;
    defparam i1_3_lut_adj_225.init = 16'h8080;
    ORCALUT4 i15_4_lut_adj_226 (.A(memory_addr[1]), .B(rx_buffer_reg[4]), 
            .C(n8622), .D(baudrate_reg[4]), .Z(n26_adj_917)) /* synthesis lut_function=(A (B (C))+!A !(C+!(D))) */ ;   // c:/lscc/ep16vhdl/ep16_chip.vhd(124[9:20])
    defparam i15_4_lut_adj_226.init = 16'h8580;
    ORCALUT4 i1_4_lut_adj_227 (.A(n8621), .B(n8615), .C(n7001), .D(n8618), 
            .Z(n7011)) /* synthesis lut_function=(!(A+(B+!(C (D))))) */ ;
    defparam i1_4_lut_adj_227.init = 16'h1000;
    ORCALUT4 i1_2_lut_3_lut (.A(system_write), .B(n8621), .C(n7025), .Z(n7027)) /* synthesis lut_function=(A (B (C))) */ ;
    defparam i1_2_lut_3_lut.init = 16'h8080;
    ORCALUT4 i1_4_lut_adj_228 (.A(p[11]), .B(n6903), .C(n6901), .D(p[13]), 
            .Z(n6766)) /* synthesis lut_function=(A (B (C (D)))) */ ;
    defparam i1_4_lut_adj_228.init = 16'h8000;
    ORCALUT4 i1_2_lut_adj_229 (.A(n18), .B(system_write), .Z(n7001)) /* synthesis lut_function=(A (B)) */ ;
    defparam i1_2_lut_adj_229.init = 16'h8888;
    ORCALUT4 i10_4_lut (.A(i[5]), .B(n8596), .C(n8653), .D(p_in_15__N_282[5]), 
            .Z(n6)) /* synthesis lut_function=(A (B ((D)+!C)+!B !(C))+!A (B (C (D)))) */ ;   // c:/lscc/ep16vhdl/ep16.vhd(55[9:14])
    defparam i10_4_lut.init = 16'hca0a;
    ORCALUT4 i1160_1_lut (.A(gpio_dir[15]), .Z(n1853)) /* synthesis lut_function=(!(A)) */ ;   // c:/lscc/ep16vhdl/ep16_chip.vhd(44[2:8])
    defparam i1160_1_lut.init = 16'h5555;
    ORCALUT4 i7032_3_lut (.A(n7694), .B(n7695), .C(sp[3]), .Z(n1305)) /* synthesis lut_function=(A (B+!(C))+!A (B (C))) */ ;
    defparam i7032_3_lut.init = 16'hcaca;
    ORCALUT4 i7220_3_lut (.A(n30_adj_923), .B(ioport_out_2), .C(memory_addr[1]), 
            .Z(n19_adj_924)) /* synthesis lut_function=(A (B+!(C))+!A (B (C))) */ ;   // c:/lscc/ep16vhdl/uart16.vhd(37[3:9])
    defparam i7220_3_lut.init = 16'hcaca;
    ORCALUT4 i29_3_lut_adj_230 (.A(gpio_out[2]), .B(gpio_dir[2]), .C(n8622), 
            .Z(n30_adj_923)) /* synthesis lut_function=(A (B+!(C))+!A (B (C))) */ ;   // c:/lscc/ep16vhdl/ep16_chip.vhd(124[9:20])
    defparam i29_3_lut_adj_230.init = 16'hcaca;
    ORCALUT4 i15_4_lut_adj_231 (.A(memory_addr[1]), .B(rx_buffer_reg[2]), 
            .C(n8622), .D(baudrate_reg[2]), .Z(n26_adj_925)) /* synthesis lut_function=(A (B (C))+!A !(C+!(D))) */ ;   // c:/lscc/ep16vhdl/ep16_chip.vhd(124[9:20])
    defparam i15_4_lut_adj_231.init = 16'h8580;
    ORCALUT4 i7222_3_lut (.A(n30_adj_927), .B(ioport_out_1), .C(memory_addr[1]), 
            .Z(n19)) /* synthesis lut_function=(A (B+!(C))+!A (B (C))) */ ;   // c:/lscc/ep16vhdl/uart16.vhd(37[3:9])
    defparam i7222_3_lut.init = 16'hcaca;
    ORCALUT4 i29_3_lut_adj_232 (.A(gpio_out[1]), .B(gpio_dir[1]), .C(n8622), 
            .Z(n30_adj_927)) /* synthesis lut_function=(A (B+!(C))+!A (B (C))) */ ;   // c:/lscc/ep16vhdl/ep16_chip.vhd(124[9:20])
    defparam i29_3_lut_adj_232.init = 16'hcaca;
    ORCALUT4 i15_4_lut_adj_233 (.A(memory_addr[1]), .B(rx_buffer_reg[1]), 
            .C(n8622), .D(baudrate_reg[1]), .Z(n26)) /* synthesis lut_function=(A (B (C))+!A !(C+!(D))) */ ;   // c:/lscc/ep16vhdl/ep16_chip.vhd(124[9:20])
    defparam i15_4_lut_adj_233.init = 16'h8580;
    ORCALUT4 mux_595_i12_3_lut (.A(gpio_out[11]), .B(baudrate_reg[11]), 
            .C(data_o_15__N_441), .Z(n1167)) /* synthesis lut_function=(A (B+!(C))+!A (B (C))) */ ;   // c:/lscc/ep16vhdl/uart16.vhd(80[2] 95[9])
    defparam mux_595_i12_3_lut.init = 16'hcaca;
    PFUMX i7011 (.BLUT(n7667), .ALUT(n7668), .C0(sp1[1]), .Z(n7675));
    ORCALUT4 mux_595_i11_3_lut (.A(gpio_out[10]), .B(baudrate_reg[10]), 
            .C(data_o_15__N_441), .Z(n1168)) /* synthesis lut_function=(A (B+!(C))+!A (B (C))) */ ;   // c:/lscc/ep16vhdl/uart16.vhd(80[2] 95[9])
    defparam mux_595_i11_3_lut.init = 16'hcaca;
    ORCALUT4 i1182_4_lut (.A(system_data_o_15__N_31), .B(system_data_o_15__N_51), 
            .C(memory_data_i[6]), .D(system_write), .Z(system_data_o[6])) /* synthesis lut_function=(A (B (C+!(D)))+!A (B (C (D)))) */ ;   // c:/lscc/ep16vhdl/ep16_chip.vhd(198[2:15])
    defparam i1182_4_lut.init = 16'hc088;
    ORCALUT4 i18_4_lut_adj_234 (.A(memory_data_o[6]), .B(n6537), .C(n8618), 
            .D(n28_adj_908), .Z(system_data_o_15__N_31)) /* synthesis lut_function=(A (((D)+!C)+!B)+!A (B (C (D))+!B (C))) */ ;   // c:/lscc/ep16vhdl/uart16.vhd(37[3:9])
    defparam i18_4_lut_adj_234.init = 16'hfa3a;
    PFUMX i7702 (.BLUT(n8743), .ALUT(n8744), .C0(rx_en), .Z(rx_counter_15__N_609[1]));
    PFUMX i7700 (.BLUT(n8740), .ALUT(n8741), .C0(rx_en), .Z(rx_counter_15__N_609[2]));
    PFUMX i3143 (.BLUT(n4), .ALUT(n3860), .C0(n8653), .Z(p_in[0]));
    ORCALUT4 i9_3_lut_4_lut (.A(p_in_15__N_282[5]), .B(r[5]), .C(n7), 
            .D(n6376), .Z(n5)) /* synthesis lut_function=(A (B+!(C (D)))+!A (B (C (D)))) */ ;   // c:/lscc/ep16vhdl/ep16.vhd(55[9:14])
    defparam i9_3_lut_4_lut.init = 16'hcaaa;
    PFUMX i7698 (.BLUT(n8737), .ALUT(n8738), .C0(rx_en), .Z(rx_counter_15__N_609[3]));
    ORCALUT4 mux_595_i10_3_lut (.A(gpio_out[9]), .B(baudrate_reg[9]), .C(data_o_15__N_441), 
            .Z(n1169)) /* synthesis lut_function=(A (B+!(C))+!A (B (C))) */ ;   // c:/lscc/ep16vhdl/uart16.vhd(80[2] 95[9])
    defparam mux_595_i10_3_lut.init = 16'hcaca;
    PFUMX i7696 (.BLUT(n8734), .ALUT(n8735), .C0(rx_en), .Z(rx_counter_15__N_609[4]));
    PFUMX i7012 (.BLUT(n7669), .ALUT(n7670), .C0(sp1[1]), .Z(n7676));
    PFUMX i7694 (.BLUT(n8731), .ALUT(n8732), .C0(rx_en), .Z(rx_counter_15__N_609[5]));
    PFUMX i7013 (.BLUT(n7671), .ALUT(n7672), .C0(sp1[1]), .Z(n7677));
    ORCALUT4 i7_3_lut_4_lut (.A(p_in_15__N_282[0]), .B(r[0]), .C(n7), 
            .D(n6376), .Z(n3_adj_914)) /* synthesis lut_function=(A (B+!(C (D)))+!A (B (C (D)))) */ ;   // c:/lscc/ep16vhdl/ep16.vhd(55[9:14])
    defparam i7_3_lut_4_lut.init = 16'hcaaa;
    ORCALUT4 mux_595_i8_3_lut (.A(gpio_out[7]), .B(baudrate_reg[7]), .C(data_o_15__N_441), 
            .Z(n1171)) /* synthesis lut_function=(A (B+!(C))+!A (B (C))) */ ;   // c:/lscc/ep16vhdl/uart16.vhd(80[2] 95[9])
    defparam mux_595_i8_3_lut.init = 16'hcaca;
    ORCALUT4 i3527_2_lut_rep_253_3_lut (.A(n8664), .B(n1305), .C(n1323), 
            .Z(n8633)) /* synthesis lut_function=(A (B (C))) */ ;   // c:/lscc/ep16vhdl/ep16.vhd(47[9:16])
    defparam i3527_2_lut_rep_253_3_lut.init = 16'h8080;
    ORCALUT4 mux_595_i13_3_lut (.A(gpio_out[12]), .B(baudrate_reg[12]), 
            .C(data_o_15__N_441), .Z(n1166)) /* synthesis lut_function=(A (B+!(C))+!A (B (C))) */ ;   // c:/lscc/ep16vhdl/uart16.vhd(80[2] 95[9])
    defparam mux_595_i13_3_lut.init = 16'hcaca;
    VLO i1 (.Z(GND_net));
    PUR PUR_INST (.PUR(VCC_net));
    defparam PUR_INST.RST_PULSE = 1;
    ORCALUT4 i3415_2_lut_rep_252_3_lut (.A(n8664), .B(n1305), .C(n1322), 
            .Z(n8632)) /* synthesis lut_function=(A (B (C))) */ ;   // c:/lscc/ep16vhdl/ep16.vhd(47[9:16])
    defparam i3415_2_lut_rep_252_3_lut.init = 16'h8080;
    uart uart1 (.n18(n18), .\memory_addr[1] (memory_addr[1]), .n8618(n8618), 
         .system_write(system_write), .n8601(n8601), .n8607(n8607), .baudrate_reg({baudrate_reg}), 
         .rx_irq_o_N_643(rx_irq_o_N_643), .n8660(n8660), .aclk_c(aclk_c), 
         .rxd_ff(rxd_ff), .\tx_counter[5] (tx_counter[5]), .GND_net(GND_net), 
         .VCC_net(VCC_net), .\tx_counter[6] (tx_counter[6]), .n87({Open_0, 
         Open_1, Open_2, Open_3, Open_4, Open_5, Open_6, Open_7, 
         Open_8, n63, n66, n69, n72, n75, n78, Open_9}), .rx_en(rx_en), 
         .tx_en(tx_en), .\tx_counter[3] (tx_counter[3]), .\tx_counter[4] (tx_counter[4]), 
         .\tx_counter[1] (tx_counter[1]), .\tx_counter[2] (tx_counter[2]), 
         .\rx_counter_15__N_609[0] (rx_counter_15__N_609[0]), .rxb_full(rxb_full), 
         .system_data_o({system_data_o}), .uart_i_c(uart_i_c), .rx_buffer_reg({rx_buffer_reg}), 
         .tx_en_N_533(tx_en_N_533), .n66_adj_1(n66_adj_901), .n7403(n7403), 
         .n7011(n7011), .n72_adj_2(n72_adj_903), .n69_adj_3(n69_adj_902), 
         .n78_adj_4(n78_adj_905), .n75_adj_5(n75_adj_904), .n81(n81), 
         .n780(n780), .n8651(n8651), .hw_xonoff_ff(hw_xonoff_ff), .n7405(n7405), 
         .n8621(n8621), .n8617(n8617), .n6833(n6833), .n8622(n8622), 
         .n9433(n9433), .n3964(n3964), .n7043(n7043), .\memory_addr[5] (memory_addr[5]), 
         .n3994(n3994), .n4024(n4024), .n4054(n4054), .n4084(n4084), 
         .n4114(n4114), .uart_o_c(uart_o_c), .\rx_counter_15__N_609[1] (rx_counter_15__N_609[1]), 
         .\rx_counter_15__N_609[2] (rx_counter_15__N_609[2]), .\rx_counter_15__N_609[3] (rx_counter_15__N_609[3]), 
         .\rx_counter_15__N_609[4] (rx_counter_15__N_609[4]), .\rx_counter_15__N_609[5] (rx_counter_15__N_609[5]), 
         .\memory_addr[4] (memory_addr[4]), .n8606(n8606), .n7401(n7401), 
         .n8602(n8602), .n8616(n8616), .n1996(n1996), .system_read(system_read), 
         .\gpio_dir[0] (gpio_dir[0]), .n1162(n1162), .n8592(n8592));   // c:/lscc/ep16vhdl/ep16_chip.vhd(208[11:15])
    PFUMX i7014 (.BLUT(n7673), .ALUT(n7674), .C0(sp1[1]), .Z(n7678));
    ram_memory ram_memory_0 (.aclk_N_55(aclk_N_55), .VCC_net(VCC_net), .GND_net(GND_net), 
            .system_write(system_write), .\memory_addr[11] (memory_addr[11]), 
            .\memory_addr[10] (memory_addr[10]), .\memory_addr[9] (memory_addr[9]), 
            .\memory_addr[8] (memory_addr[8]), .n8616(n8616), .n8615(n8615), 
            .\memory_addr[5] (memory_addr[5]), .\memory_addr[4] (memory_addr[4]), 
            .n8617(n8617), .n8621(n8621), .\memory_addr[1] (memory_addr[1]), 
            .n8622(n8622), .memory_data_i({memory_data_i}), .memory_data_o({memory_data_o}));   // c:/lscc/ep16vhdl/ep16_chip.vhd(237[16:26])
    \ep16(16)  cpu1 (.system_data_o({system_data_o}), .memory_data_i({memory_data_i}), 
            .n1476(n1476), .n1493(n1493), .sp({sp}), .n1335(n1335), 
            .p({Open_10, Open_11, Open_12, Open_13, Open_14, p[10:8], 
            Open_15, Open_16, Open_17, Open_18, Open_19, Open_20, 
            Open_21, Open_22}), .aclk_c(aclk_c), .n3(n3), .n1328(n1328), 
            .n8640(n8640), .sp1({sp1}), .\p_in[5] (p_in[5]), .rp({rp}), 
            .\p_sel[1] (p_sel[1]), .interrupt_i_c_1(interrupt_i_c_1), .\p_in_15__N_282[0] (p_in_15__N_282[0]), 
            .interrupt_i_c_0(interrupt_i_c_0), .n3860(n3860), .n8653(n8653), 
            .n1326(n1326), .n8637(n8637), .system_write(system_write), 
            .n8603(n8603), .rp1({rp1}), .arst_c(arst_c), .n1537(n1537), 
            .n1305(n1305), .n8664(n8664), .n1322(n1322), .n1323(n1323), 
            .\a[10] (a[10]), .r({r}), .\p_in[0] (p_in[0]), .\i[0] (i[0]), 
            .\a[14] (a[14]), .\a[13] (a[13]), .\a[12] (a[12]), .\a[11] (a[11]), 
            .\slot[0] (slot[0]), .n8666(n8666), .GND_net(GND_net), .VCC_net(VCC_net), 
            .n1321(n1321), .aclk_c_enable_78(aclk_c_enable_78), .\p[13] (p[13]), 
            .\p[14] (p[14]), .tx_en(tx_en), .n8606(n8606), .\p[11] (p[11]), 
            .\p[12] (p[12]), .n1435(n1435), .n1502(n1502), .n1519(n1519), 
            .\i[5] (i[5]), .n1516(n1516), .n1533(n1533), .n1536(n1536), 
            .n8614(n8614), .\memory_addr[1] (memory_addr[1]), .n8602(n8602), 
            .n7611(n7611), .\a[9] (a[9]), .n8675(n8675), .\p_in_15__N_282[5] (p_in_15__N_282[5]), 
            .n6376(n6376), .n1419(n1419), .n1424(n1424), .n7595(n7595), 
            .\a[8] (a[8]), .\slot[1] (slot[1]), .n7161(n7161), .n1336(n1336), 
            .n1334(n1334), .\t[16] (t[16]), .n1467(n1467), .n1484(n1484), 
            .n7(n7), .n8623(n8623), .n1329(n1329), .n1469(n1469), .n1486(n1486), 
            .n1330(n1330), .n8596(n8596), .n1325(n1325), .n1327(n1327), 
            .n1462(n1462), .n1479(n1479), .n1331(n1331), .n1332(n1332), 
            .\memory_addr[5] (memory_addr[5]), .n8607(n8607), .n8616(n8616), 
            .n7043(n7043), .n1333(n1333), .n1478(n1478), .n1495(n1495), 
            .n963(n963), .n8663(n8663), .n1371(n1371), .n7549(n7549), 
            .n1361(n1361), .n7565(n7565), .\memory_addr[4] (memory_addr[4]), 
            .n8608(n8608), .n8601(n8601), .n8604(n8604), .n8661(n8661), 
            .n1366(n1366), .n7564(n7564), .n1411(n1411), .n7550(n7550), 
            .n1401(n1401), .n7562(n7562), .n1416(n1416), .n7548(n7548), 
            .n1406(n1406), .n7556(n7556), .n1376(n1376), .n7569(n7569), 
            .n1381(n1381), .n7568(n7568), .n8628(n8628), .n1324(n1324), 
            .n6833(n6833), .n6835(n6835), .n18(n18), .n7025(n7025), 
            .n1391(n1391), .n7566(n7566), .n1386(n1386), .n7567(n7567), 
            .n1396(n1396), .n7563(n7563), .acknowledge_o_c(acknowledge_o_c), 
            .n6010(n6010), .n8671(n8671), .n8630(n8630), .n8627(n8627), 
            .n8626(n8626), .n8618(n8618), .n8615(n8615), .system_read(system_read), 
            .n8625(n8625), .interrupt_i_c_3(interrupt_i_c_3), .n8674(n8674), 
            .n1497(n1497), .interrupt_i_c_2(interrupt_i_c_2), .interrupt_i_c_4(interrupt_i_c_4), 
            .n8624(n8624), .n8617(n8617), .n8613(n8613), .n8619(n8619), 
            .n1(n1), .n1427(n1427), .n1501(n1501), .n1518(n1518), .n8620(n8620), 
            .n8612(n8612), .n1514(n1514), .n1531(n1531), .n1517(n1517), 
            .n1534(n1534), .n1468(n1468), .n1485(n1485), .n8634(n8634), 
            .n1513(n1513), .n1530(n1530), .n1500(n1500), .n1512(n1512), 
            .n1529(n1529), .n8633(n8633), .n1511(n1511), .n1528(n1528), 
            .\memory_addr[11] (memory_addr[11]), .\memory_addr[10] (memory_addr[10]), 
            .n8599(n8599), .n1466(n1466), .n1483(n1483), .n8668(n8668), 
            .n1510(n1510), .n1527(n1527), .n8632(n8632), .\memory_addr[9] (memory_addr[9]), 
            .\memory_addr[8] (memory_addr[8]), .n8621(n8621), .n1463(n1463), 
            .n1480(n1480), .n1464(n1464), .n1481(n1481), .n1509(n1509), 
            .n1526(n1526), .n1473(n1473), .n1490(n1490), .n1474(n1474), 
            .n1491(n1491), .n1471(n1471), .n1488(n1488), .n1472(n1472), 
            .n1489(n1489), .n1508(n1508), .n1525(n1525), .n1507(n1507), 
            .n1524(n1524), .n8631(n8631), .n8622(n8622), .n1506(n1506), 
            .n1523(n1523), .n1515(n1515), .n1532(n1532), .n8629(n8629), 
            .n7105(n7105), .n1505(n1505), .n1522(n1522), .n1504(n1504), 
            .n1521(n1521), .n1465(n1465), .n1482(n1482), .aclk_c_enable_16(aclk_c_enable_16), 
            .n1498(n1498), .n1226(n1226), .n7557(n7557), .n1246(n1246), 
            .n7558(n7558), .n1477(n1477), .n1494(n1494), .n1256(n1256), 
            .n8667(n8667), .n7559(n7559), .n1304(n1304), .n1309(n1309), 
            .n1503(n1503), .n1520(n1520), .n1470(n1470), .n1487(n1487), 
            .n1312(n1312), .n1266(n1266), .n7561(n7561), .n1271(n1271), 
            .n8673(n8673), .n7560(n7560), .n1231(n1231), .n7545(n7545), 
            .n1281(n1281), .n7546(n7546), .n1276(n1276), .n7555(n7555), 
            .n1236(n1236), .n7547(n7547), .n1241(n1241), .n7553(n7553), 
            .n1475(n1475), .n1492(n1492));   // c:/lscc/ep16vhdl/ep16_chip.vhd(170[8:12])
    PFUMX i17_adj_235 (.BLUT(n19_adj_920), .ALUT(n26_adj_921), .C0(data_o_15__N_441), 
          .Z(n28_adj_922));
    PFUMX i17_adj_236 (.BLUT(n19_adj_916), .ALUT(n26_adj_917), .C0(data_o_15__N_441), 
          .Z(n28_adj_918));
    
endmodule
//
// Verilog Description of module gpio
//

module gpio (\memory_addr[1] , tx_en, hw_xonoff_ff, n8616, \memory_addr[4] , 
            n8617, \memory_addr[5] , n7401, n8615, n7405, n8622, 
            gpio_out, gpio_dir, \baudrate_reg[8] , rxb_full, ioport_out_8, 
            aclk_c, aclk_c_enable_123, system_data_o, data_o_15__N_441, 
            n8245, n8603, n8602, n8618, n18, n8604, n8608, ioport_out_13, 
            n8592, n1084, ioport_out_15, ioport_out_14, \rx_buffer_reg[0] , 
            n1163, n7611, n1099, n1164, n1098, n1165, n1097, n1166, 
            n1096, n1167, n1095, n1168, n1094, n1169, n1093, n1091, 
            n1178, n1162, ioport_out_12, n7407, ioport_out_11, ioport_out_10, 
            ioport_out_9, n1171, ioport_out_7, \rx_buffer_reg[7] , ioport_out_0);
    input \memory_addr[1] ;
    input tx_en;
    input hw_xonoff_ff;
    input n8616;
    input \memory_addr[4] ;
    input n8617;
    input \memory_addr[5] ;
    output n7401;
    input n8615;
    output n7405;
    input n8622;
    output [15:0]gpio_out;
    output [15:0]gpio_dir;
    input \baudrate_reg[8] ;
    input rxb_full;
    input ioport_out_8;
    input aclk_c;
    input aclk_c_enable_123;
    input [15:0]system_data_o;
    input data_o_15__N_441;
    output n8245;
    input n8603;
    input n8602;
    input n8618;
    input n18;
    input n8604;
    input n8608;
    input ioport_out_13;
    input n8592;
    output n1084;
    input ioport_out_15;
    input ioport_out_14;
    input \rx_buffer_reg[0] ;
    input n1163;
    input n7611;
    output n1099;
    input n1164;
    output n1098;
    input n1165;
    output n1097;
    input n1166;
    output n1096;
    input n1167;
    output n1095;
    input n1168;
    output n1094;
    input n1169;
    output n1093;
    output n1091;
    input n1178;
    input n1162;
    input ioport_out_12;
    output n7407;
    input ioport_out_11;
    input ioport_out_10;
    input ioport_out_9;
    input n1171;
    input ioport_out_7;
    input \rx_buffer_reg[7] ;
    input ioport_out_0;
    
    wire aclk_c /* synthesis SET_AS_NETWORK=aclk_c, is_clock=1 */ ;   // c:/lscc/ep16vhdl/ep16_chip.vhd(36[2:6])
    
    wire n8240, n8243, n8241, n8244, aclk_c_enable_138, n8242, n6969, 
        n1, n1_adj_893, n2194, n1_adj_894, n1_adj_895, n2193, n1_adj_896, 
        n1_adj_897, n1_adj_898, n1_adj_899, n1_adj_900, n2378;
    
    ORCALUT4 memory_addr_0__bdd_3_lut_7482 (.A(\memory_addr[1] ), .B(tx_en), 
            .C(hw_xonoff_ff), .Z(n8240)) /* synthesis lut_function=(!(A+(B+(C)))) */ ;
    defparam memory_addr_0__bdd_3_lut_7482.init = 16'h0101;
    ORCALUT4 i6737_2_lut_3_lut_4_lut (.A(n8616), .B(\memory_addr[4] ), .C(n8617), 
            .D(\memory_addr[5] ), .Z(n7401)) /* synthesis lut_function=(A+(B+(C+(D)))) */ ;
    defparam i6737_2_lut_3_lut_4_lut.init = 16'hfffe;
    ORCALUT4 i6741_2_lut_3_lut_4_lut (.A(n8616), .B(\memory_addr[4] ), .C(n8615), 
            .D(\memory_addr[5] ), .Z(n7405)) /* synthesis lut_function=(A+(B+(C+(D)))) */ ;
    defparam i6741_2_lut_3_lut_4_lut.init = 16'hfffe;
    ORCALUT4 memory_addr_0__bdd_3_lut_7516 (.A(n8622), .B(gpio_out[8]), 
            .C(gpio_dir[8]), .Z(n8243)) /* synthesis lut_function=(A (C)+!A (B)) */ ;
    defparam memory_addr_0__bdd_3_lut_7516.init = 16'he4e4;
    ORCALUT4 memory_addr_0__bdd_3_lut_7485 (.A(\memory_addr[1] ), .B(\baudrate_reg[8] ), 
            .C(rxb_full), .Z(n8241)) /* synthesis lut_function=(A (C)+!A (B)) */ ;
    defparam memory_addr_0__bdd_3_lut_7485.init = 16'he4e4;
    ORCALUT4 n8243_bdd_3_lut (.A(n8243), .B(ioport_out_8), .C(\memory_addr[1] ), 
            .Z(n8244)) /* synthesis lut_function=(A (B+!(C))+!A (B (C))) */ ;
    defparam n8243_bdd_3_lut.init = 16'hcaca;
    FD1P3AX gpio_dir_reg_i0_i0 (.D(system_data_o[0]), .SP(aclk_c_enable_123), 
            .CK(aclk_c), .Q(gpio_dir[0])) /* synthesis LSE_LINE_FILE_ID=21, LSE_LCOL=11, LSE_RCOL=15, LSE_LLINE=252, LSE_RLINE=252 */ ;   // c:/lscc/ep16vhdl/gpio16.vhd(73[2] 83[9])
    defparam gpio_dir_reg_i0_i0.GSR = "ENABLED";
    FD1P3AX gpio_reg_i0_i0 (.D(system_data_o[0]), .SP(aclk_c_enable_138), 
            .CK(aclk_c), .Q(gpio_out[0])) /* synthesis LSE_LINE_FILE_ID=21, LSE_LCOL=11, LSE_RCOL=15, LSE_LLINE=252, LSE_RLINE=252 */ ;   // c:/lscc/ep16vhdl/gpio16.vhd(73[2] 83[9])
    defparam gpio_reg_i0_i0.GSR = "ENABLED";
    ORCALUT4 n8244_bdd_3_lut (.A(n8244), .B(n8242), .C(data_o_15__N_441), 
            .Z(n8245)) /* synthesis lut_function=(A (B+!(C))+!A (B (C))) */ ;
    defparam n8244_bdd_3_lut.init = 16'hcaca;
    FD1P3AX gpio_dir_reg_i0_i1 (.D(system_data_o[1]), .SP(aclk_c_enable_123), 
            .CK(aclk_c), .Q(gpio_dir[1])) /* synthesis LSE_LINE_FILE_ID=21, LSE_LCOL=11, LSE_RCOL=15, LSE_LLINE=252, LSE_RLINE=252 */ ;   // c:/lscc/ep16vhdl/gpio16.vhd(73[2] 83[9])
    defparam gpio_dir_reg_i0_i1.GSR = "ENABLED";
    FD1P3AX gpio_dir_reg_i0_i2 (.D(system_data_o[2]), .SP(aclk_c_enable_123), 
            .CK(aclk_c), .Q(gpio_dir[2])) /* synthesis LSE_LINE_FILE_ID=21, LSE_LCOL=11, LSE_RCOL=15, LSE_LLINE=252, LSE_RLINE=252 */ ;   // c:/lscc/ep16vhdl/gpio16.vhd(73[2] 83[9])
    defparam gpio_dir_reg_i0_i2.GSR = "ENABLED";
    FD1P3AX gpio_dir_reg_i0_i3 (.D(system_data_o[3]), .SP(aclk_c_enable_123), 
            .CK(aclk_c), .Q(gpio_dir[3])) /* synthesis LSE_LINE_FILE_ID=21, LSE_LCOL=11, LSE_RCOL=15, LSE_LLINE=252, LSE_RLINE=252 */ ;   // c:/lscc/ep16vhdl/gpio16.vhd(73[2] 83[9])
    defparam gpio_dir_reg_i0_i3.GSR = "ENABLED";
    FD1P3AX gpio_dir_reg_i0_i4 (.D(system_data_o[4]), .SP(aclk_c_enable_123), 
            .CK(aclk_c), .Q(gpio_dir[4])) /* synthesis LSE_LINE_FILE_ID=21, LSE_LCOL=11, LSE_RCOL=15, LSE_LLINE=252, LSE_RLINE=252 */ ;   // c:/lscc/ep16vhdl/gpio16.vhd(73[2] 83[9])
    defparam gpio_dir_reg_i0_i4.GSR = "ENABLED";
    FD1P3AX gpio_dir_reg_i0_i5 (.D(system_data_o[5]), .SP(aclk_c_enable_123), 
            .CK(aclk_c), .Q(gpio_dir[5])) /* synthesis LSE_LINE_FILE_ID=21, LSE_LCOL=11, LSE_RCOL=15, LSE_LLINE=252, LSE_RLINE=252 */ ;   // c:/lscc/ep16vhdl/gpio16.vhd(73[2] 83[9])
    defparam gpio_dir_reg_i0_i5.GSR = "ENABLED";
    FD1P3AX gpio_dir_reg_i0_i6 (.D(system_data_o[6]), .SP(aclk_c_enable_123), 
            .CK(aclk_c), .Q(gpio_dir[6])) /* synthesis LSE_LINE_FILE_ID=21, LSE_LCOL=11, LSE_RCOL=15, LSE_LLINE=252, LSE_RLINE=252 */ ;   // c:/lscc/ep16vhdl/gpio16.vhd(73[2] 83[9])
    defparam gpio_dir_reg_i0_i6.GSR = "ENABLED";
    FD1P3AX gpio_dir_reg_i0_i7 (.D(system_data_o[7]), .SP(aclk_c_enable_123), 
            .CK(aclk_c), .Q(gpio_dir[7])) /* synthesis LSE_LINE_FILE_ID=21, LSE_LCOL=11, LSE_RCOL=15, LSE_LLINE=252, LSE_RLINE=252 */ ;   // c:/lscc/ep16vhdl/gpio16.vhd(73[2] 83[9])
    defparam gpio_dir_reg_i0_i7.GSR = "ENABLED";
    FD1P3AX gpio_dir_reg_i0_i8 (.D(system_data_o[8]), .SP(aclk_c_enable_123), 
            .CK(aclk_c), .Q(gpio_dir[8])) /* synthesis LSE_LINE_FILE_ID=21, LSE_LCOL=11, LSE_RCOL=15, LSE_LLINE=252, LSE_RLINE=252 */ ;   // c:/lscc/ep16vhdl/gpio16.vhd(73[2] 83[9])
    defparam gpio_dir_reg_i0_i8.GSR = "ENABLED";
    FD1P3AX gpio_dir_reg_i0_i9 (.D(system_data_o[9]), .SP(aclk_c_enable_123), 
            .CK(aclk_c), .Q(gpio_dir[9])) /* synthesis LSE_LINE_FILE_ID=21, LSE_LCOL=11, LSE_RCOL=15, LSE_LLINE=252, LSE_RLINE=252 */ ;   // c:/lscc/ep16vhdl/gpio16.vhd(73[2] 83[9])
    defparam gpio_dir_reg_i0_i9.GSR = "ENABLED";
    FD1P3AX gpio_dir_reg_i0_i10 (.D(system_data_o[10]), .SP(aclk_c_enable_123), 
            .CK(aclk_c), .Q(gpio_dir[10])) /* synthesis LSE_LINE_FILE_ID=21, LSE_LCOL=11, LSE_RCOL=15, LSE_LLINE=252, LSE_RLINE=252 */ ;   // c:/lscc/ep16vhdl/gpio16.vhd(73[2] 83[9])
    defparam gpio_dir_reg_i0_i10.GSR = "ENABLED";
    FD1P3AX gpio_dir_reg_i0_i11 (.D(system_data_o[11]), .SP(aclk_c_enable_123), 
            .CK(aclk_c), .Q(gpio_dir[11])) /* synthesis LSE_LINE_FILE_ID=21, LSE_LCOL=11, LSE_RCOL=15, LSE_LLINE=252, LSE_RLINE=252 */ ;   // c:/lscc/ep16vhdl/gpio16.vhd(73[2] 83[9])
    defparam gpio_dir_reg_i0_i11.GSR = "ENABLED";
    FD1P3AX gpio_dir_reg_i0_i12 (.D(system_data_o[12]), .SP(aclk_c_enable_123), 
            .CK(aclk_c), .Q(gpio_dir[12])) /* synthesis LSE_LINE_FILE_ID=21, LSE_LCOL=11, LSE_RCOL=15, LSE_LLINE=252, LSE_RLINE=252 */ ;   // c:/lscc/ep16vhdl/gpio16.vhd(73[2] 83[9])
    defparam gpio_dir_reg_i0_i12.GSR = "ENABLED";
    FD1P3AX gpio_dir_reg_i0_i13 (.D(system_data_o[13]), .SP(aclk_c_enable_123), 
            .CK(aclk_c), .Q(gpio_dir[13])) /* synthesis LSE_LINE_FILE_ID=21, LSE_LCOL=11, LSE_RCOL=15, LSE_LLINE=252, LSE_RLINE=252 */ ;   // c:/lscc/ep16vhdl/gpio16.vhd(73[2] 83[9])
    defparam gpio_dir_reg_i0_i13.GSR = "ENABLED";
    FD1P3AX gpio_dir_reg_i0_i14 (.D(system_data_o[14]), .SP(aclk_c_enable_123), 
            .CK(aclk_c), .Q(gpio_dir[14])) /* synthesis LSE_LINE_FILE_ID=21, LSE_LCOL=11, LSE_RCOL=15, LSE_LLINE=252, LSE_RLINE=252 */ ;   // c:/lscc/ep16vhdl/gpio16.vhd(73[2] 83[9])
    defparam gpio_dir_reg_i0_i14.GSR = "ENABLED";
    FD1P3AX gpio_dir_reg_i0_i15 (.D(system_data_o[15]), .SP(aclk_c_enable_123), 
            .CK(aclk_c), .Q(gpio_dir[15])) /* synthesis LSE_LINE_FILE_ID=21, LSE_LCOL=11, LSE_RCOL=15, LSE_LLINE=252, LSE_RLINE=252 */ ;   // c:/lscc/ep16vhdl/gpio16.vhd(73[2] 83[9])
    defparam gpio_dir_reg_i0_i15.GSR = "ENABLED";
    FD1P3AX gpio_reg_i0_i1 (.D(system_data_o[1]), .SP(aclk_c_enable_138), 
            .CK(aclk_c), .Q(gpio_out[1])) /* synthesis LSE_LINE_FILE_ID=21, LSE_LCOL=11, LSE_RCOL=15, LSE_LLINE=252, LSE_RLINE=252 */ ;   // c:/lscc/ep16vhdl/gpio16.vhd(73[2] 83[9])
    defparam gpio_reg_i0_i1.GSR = "ENABLED";
    FD1P3AX gpio_reg_i0_i2 (.D(system_data_o[2]), .SP(aclk_c_enable_138), 
            .CK(aclk_c), .Q(gpio_out[2])) /* synthesis LSE_LINE_FILE_ID=21, LSE_LCOL=11, LSE_RCOL=15, LSE_LLINE=252, LSE_RLINE=252 */ ;   // c:/lscc/ep16vhdl/gpio16.vhd(73[2] 83[9])
    defparam gpio_reg_i0_i2.GSR = "ENABLED";
    FD1P3AX gpio_reg_i0_i3 (.D(system_data_o[3]), .SP(aclk_c_enable_138), 
            .CK(aclk_c), .Q(gpio_out[3])) /* synthesis LSE_LINE_FILE_ID=21, LSE_LCOL=11, LSE_RCOL=15, LSE_LLINE=252, LSE_RLINE=252 */ ;   // c:/lscc/ep16vhdl/gpio16.vhd(73[2] 83[9])
    defparam gpio_reg_i0_i3.GSR = "ENABLED";
    FD1P3AX gpio_reg_i0_i4 (.D(system_data_o[4]), .SP(aclk_c_enable_138), 
            .CK(aclk_c), .Q(gpio_out[4])) /* synthesis LSE_LINE_FILE_ID=21, LSE_LCOL=11, LSE_RCOL=15, LSE_LLINE=252, LSE_RLINE=252 */ ;   // c:/lscc/ep16vhdl/gpio16.vhd(73[2] 83[9])
    defparam gpio_reg_i0_i4.GSR = "ENABLED";
    FD1P3AX gpio_reg_i0_i5 (.D(system_data_o[5]), .SP(aclk_c_enable_138), 
            .CK(aclk_c), .Q(gpio_out[5])) /* synthesis LSE_LINE_FILE_ID=21, LSE_LCOL=11, LSE_RCOL=15, LSE_LLINE=252, LSE_RLINE=252 */ ;   // c:/lscc/ep16vhdl/gpio16.vhd(73[2] 83[9])
    defparam gpio_reg_i0_i5.GSR = "ENABLED";
    FD1P3AX gpio_reg_i0_i6 (.D(system_data_o[6]), .SP(aclk_c_enable_138), 
            .CK(aclk_c), .Q(gpio_out[6])) /* synthesis LSE_LINE_FILE_ID=21, LSE_LCOL=11, LSE_RCOL=15, LSE_LLINE=252, LSE_RLINE=252 */ ;   // c:/lscc/ep16vhdl/gpio16.vhd(73[2] 83[9])
    defparam gpio_reg_i0_i6.GSR = "ENABLED";
    FD1P3AX gpio_reg_i0_i7 (.D(system_data_o[7]), .SP(aclk_c_enable_138), 
            .CK(aclk_c), .Q(gpio_out[7])) /* synthesis LSE_LINE_FILE_ID=21, LSE_LCOL=11, LSE_RCOL=15, LSE_LLINE=252, LSE_RLINE=252 */ ;   // c:/lscc/ep16vhdl/gpio16.vhd(73[2] 83[9])
    defparam gpio_reg_i0_i7.GSR = "ENABLED";
    FD1P3AX gpio_reg_i0_i8 (.D(system_data_o[8]), .SP(aclk_c_enable_138), 
            .CK(aclk_c), .Q(gpio_out[8])) /* synthesis LSE_LINE_FILE_ID=21, LSE_LCOL=11, LSE_RCOL=15, LSE_LLINE=252, LSE_RLINE=252 */ ;   // c:/lscc/ep16vhdl/gpio16.vhd(73[2] 83[9])
    defparam gpio_reg_i0_i8.GSR = "ENABLED";
    FD1P3AX gpio_reg_i0_i9 (.D(system_data_o[9]), .SP(aclk_c_enable_138), 
            .CK(aclk_c), .Q(gpio_out[9])) /* synthesis LSE_LINE_FILE_ID=21, LSE_LCOL=11, LSE_RCOL=15, LSE_LLINE=252, LSE_RLINE=252 */ ;   // c:/lscc/ep16vhdl/gpio16.vhd(73[2] 83[9])
    defparam gpio_reg_i0_i9.GSR = "ENABLED";
    FD1P3AX gpio_reg_i0_i10 (.D(system_data_o[10]), .SP(aclk_c_enable_138), 
            .CK(aclk_c), .Q(gpio_out[10])) /* synthesis LSE_LINE_FILE_ID=21, LSE_LCOL=11, LSE_RCOL=15, LSE_LLINE=252, LSE_RLINE=252 */ ;   // c:/lscc/ep16vhdl/gpio16.vhd(73[2] 83[9])
    defparam gpio_reg_i0_i10.GSR = "ENABLED";
    FD1P3AX gpio_reg_i0_i11 (.D(system_data_o[11]), .SP(aclk_c_enable_138), 
            .CK(aclk_c), .Q(gpio_out[11])) /* synthesis LSE_LINE_FILE_ID=21, LSE_LCOL=11, LSE_RCOL=15, LSE_LLINE=252, LSE_RLINE=252 */ ;   // c:/lscc/ep16vhdl/gpio16.vhd(73[2] 83[9])
    defparam gpio_reg_i0_i11.GSR = "ENABLED";
    FD1P3AX gpio_reg_i0_i12 (.D(system_data_o[12]), .SP(aclk_c_enable_138), 
            .CK(aclk_c), .Q(gpio_out[12])) /* synthesis LSE_LINE_FILE_ID=21, LSE_LCOL=11, LSE_RCOL=15, LSE_LLINE=252, LSE_RLINE=252 */ ;   // c:/lscc/ep16vhdl/gpio16.vhd(73[2] 83[9])
    defparam gpio_reg_i0_i12.GSR = "ENABLED";
    FD1P3AX gpio_reg_i0_i13 (.D(system_data_o[13]), .SP(aclk_c_enable_138), 
            .CK(aclk_c), .Q(gpio_out[13])) /* synthesis LSE_LINE_FILE_ID=21, LSE_LCOL=11, LSE_RCOL=15, LSE_LLINE=252, LSE_RLINE=252 */ ;   // c:/lscc/ep16vhdl/gpio16.vhd(73[2] 83[9])
    defparam gpio_reg_i0_i13.GSR = "ENABLED";
    FD1P3AX gpio_reg_i0_i14 (.D(system_data_o[14]), .SP(aclk_c_enable_138), 
            .CK(aclk_c), .Q(gpio_out[14])) /* synthesis LSE_LINE_FILE_ID=21, LSE_LCOL=11, LSE_RCOL=15, LSE_LLINE=252, LSE_RLINE=252 */ ;   // c:/lscc/ep16vhdl/gpio16.vhd(73[2] 83[9])
    defparam gpio_reg_i0_i14.GSR = "ENABLED";
    FD1P3AX gpio_reg_i0_i15 (.D(system_data_o[15]), .SP(aclk_c_enable_138), 
            .CK(aclk_c), .Q(gpio_out[15])) /* synthesis LSE_LINE_FILE_ID=21, LSE_LCOL=11, LSE_RCOL=15, LSE_LLINE=252, LSE_RLINE=252 */ ;   // c:/lscc/ep16vhdl/gpio16.vhd(73[2] 83[9])
    defparam gpio_reg_i0_i15.GSR = "ENABLED";
    ORCALUT4 i7387_4_lut (.A(n8603), .B(n8602), .C(n6969), .D(n8618), 
            .Z(aclk_c_enable_138)) /* synthesis lut_function=(!((B+(C+!(D)))+!A)) */ ;   // c:/lscc/ep16vhdl/gpio16.vhd(73[2] 83[9])
    defparam i7387_4_lut.init = 16'h0200;
    ORCALUT4 i1_4_lut (.A(n18), .B(n8604), .C(n8608), .D(n8615), .Z(n6969)) /* synthesis lut_function=((B+(C+(D)))+!A) */ ;
    defparam i1_4_lut.init = 16'hfffd;
    ORCALUT4 addr_1__I_0_Mux_13_i1_4_lut (.A(gpio_dir[13]), .B(ioport_out_13), 
            .C(\memory_addr[1] ), .D(n8592), .Z(n1)) /* synthesis lut_function=(!(A (B (D)+!B (C+(D)))+!A (((D)+!C)+!B))) */ ;   // c:/lscc/ep16vhdl/gpio16.vhd(54[3] 61[12])
    defparam addr_1__I_0_Mux_13_i1_4_lut.init = 16'h00ca;
    L6MUX21 addr_1__I_0_Mux_0_i3 (.D0(n1_adj_893), .D1(n2194), .SD(\memory_addr[1] ), 
            .Z(n1084)) /* synthesis LSE_LINE_FILE_ID=21, LSE_LCOL=11, LSE_RCOL=15, LSE_LLINE=252, LSE_RLINE=252 */ ;
    ORCALUT4 addr_1__I_0_Mux_15_i1_4_lut (.A(gpio_dir[15]), .B(ioport_out_15), 
            .C(\memory_addr[1] ), .D(n8592), .Z(n1_adj_894)) /* synthesis lut_function=(!(A (B (D)+!B (C+(D)))+!A (((D)+!C)+!B))) */ ;   // c:/lscc/ep16vhdl/gpio16.vhd(54[3] 61[12])
    defparam addr_1__I_0_Mux_15_i1_4_lut.init = 16'h00ca;
    ORCALUT4 addr_1__I_0_Mux_14_i1_4_lut (.A(gpio_dir[14]), .B(ioport_out_14), 
            .C(\memory_addr[1] ), .D(n8592), .Z(n1_adj_895)) /* synthesis lut_function=(!(A (B (D)+!B (C+(D)))+!A (((D)+!C)+!B))) */ ;   // c:/lscc/ep16vhdl/gpio16.vhd(54[3] 61[12])
    defparam addr_1__I_0_Mux_14_i1_4_lut.init = 16'h00ca;
    ORCALUT4 i1469_3_lut (.A(hw_xonoff_ff), .B(\rx_buffer_reg[0] ), .C(n8622), 
            .Z(n2193)) /* synthesis lut_function=(A (B+!(C))+!A (B (C))) */ ;   // c:/lscc/ep16vhdl/gpio16.vhd(54[3] 61[12])
    defparam i1469_3_lut.init = 16'hcaca;
    PFUMX addr_1__I_0_Mux_15_i3 (.BLUT(n1163), .ALUT(n1_adj_894), .C0(n7611), 
          .Z(n1099)) /* synthesis LSE_LINE_FILE_ID=21, LSE_LCOL=11, LSE_RCOL=15, LSE_LLINE=252, LSE_RLINE=252 */ ;
    PFUMX addr_1__I_0_Mux_14_i3 (.BLUT(n1164), .ALUT(n1_adj_895), .C0(n7611), 
          .Z(n1098)) /* synthesis LSE_LINE_FILE_ID=21, LSE_LCOL=11, LSE_RCOL=15, LSE_LLINE=252, LSE_RLINE=252 */ ;
    PFUMX addr_1__I_0_Mux_13_i3 (.BLUT(n1165), .ALUT(n1), .C0(n7611), 
          .Z(n1097)) /* synthesis LSE_LINE_FILE_ID=21, LSE_LCOL=11, LSE_RCOL=15, LSE_LLINE=252, LSE_RLINE=252 */ ;
    PFUMX addr_1__I_0_Mux_12_i3 (.BLUT(n1166), .ALUT(n1_adj_896), .C0(n7611), 
          .Z(n1096)) /* synthesis LSE_LINE_FILE_ID=21, LSE_LCOL=11, LSE_RCOL=15, LSE_LLINE=252, LSE_RLINE=252 */ ;
    PFUMX addr_1__I_0_Mux_11_i3 (.BLUT(n1167), .ALUT(n1_adj_897), .C0(n7611), 
          .Z(n1095)) /* synthesis LSE_LINE_FILE_ID=21, LSE_LCOL=11, LSE_RCOL=15, LSE_LLINE=252, LSE_RLINE=252 */ ;
    PFUMX addr_1__I_0_Mux_10_i3 (.BLUT(n1168), .ALUT(n1_adj_898), .C0(n7611), 
          .Z(n1094)) /* synthesis LSE_LINE_FILE_ID=21, LSE_LCOL=11, LSE_RCOL=15, LSE_LLINE=252, LSE_RLINE=252 */ ;
    PFUMX addr_1__I_0_Mux_9_i3 (.BLUT(n1169), .ALUT(n1_adj_899), .C0(n7611), 
          .Z(n1093)) /* synthesis LSE_LINE_FILE_ID=21, LSE_LCOL=11, LSE_RCOL=15, LSE_LLINE=252, LSE_RLINE=252 */ ;
    PFUMX addr_1__I_0_Mux_7_i3 (.BLUT(n1_adj_900), .ALUT(n2378), .C0(\memory_addr[1] ), 
          .Z(n1091)) /* synthesis LSE_LINE_FILE_ID=21, LSE_LCOL=11, LSE_RCOL=15, LSE_LLINE=252, LSE_RLINE=252 */ ;
    PFUMX addr_1__I_0_Mux_0_i1 (.BLUT(n1178), .ALUT(n1162), .C0(n8622), 
          .Z(n1_adj_893)) /* synthesis LSE_LINE_FILE_ID=21, LSE_LCOL=11, LSE_RCOL=15, LSE_LLINE=252, LSE_RLINE=252 */ ;
    PFUMX i7483 (.BLUT(n8241), .ALUT(n8240), .C0(n8622), .Z(n8242));
    ORCALUT4 addr_1__I_0_Mux_12_i1_4_lut (.A(gpio_dir[12]), .B(ioport_out_12), 
            .C(\memory_addr[1] ), .D(n8592), .Z(n1_adj_896)) /* synthesis lut_function=(!(A (B (D)+!B (C+(D)))+!A (((D)+!C)+!B))) */ ;   // c:/lscc/ep16vhdl/gpio16.vhd(54[3] 61[12])
    defparam addr_1__I_0_Mux_12_i1_4_lut.init = 16'h00ca;
    ORCALUT4 i6743_3_lut_4_lut (.A(\memory_addr[5] ), .B(n8617), .C(\memory_addr[4] ), 
            .D(n8615), .Z(n7407)) /* synthesis lut_function=(A+(B+(C+(D)))) */ ;
    defparam i6743_3_lut_4_lut.init = 16'hfffe;
    ORCALUT4 addr_1__I_0_Mux_11_i1_4_lut (.A(gpio_dir[11]), .B(ioport_out_11), 
            .C(\memory_addr[1] ), .D(n8592), .Z(n1_adj_897)) /* synthesis lut_function=(!(A (B (D)+!B (C+(D)))+!A (((D)+!C)+!B))) */ ;   // c:/lscc/ep16vhdl/gpio16.vhd(54[3] 61[12])
    defparam addr_1__I_0_Mux_11_i1_4_lut.init = 16'h00ca;
    ORCALUT4 addr_1__I_0_Mux_10_i1_4_lut (.A(gpio_dir[10]), .B(ioport_out_10), 
            .C(\memory_addr[1] ), .D(n8592), .Z(n1_adj_898)) /* synthesis lut_function=(!(A (B (D)+!B (C+(D)))+!A (((D)+!C)+!B))) */ ;   // c:/lscc/ep16vhdl/gpio16.vhd(54[3] 61[12])
    defparam addr_1__I_0_Mux_10_i1_4_lut.init = 16'h00ca;
    ORCALUT4 addr_1__I_0_Mux_9_i1_4_lut (.A(gpio_dir[9]), .B(ioport_out_9), 
            .C(\memory_addr[1] ), .D(n8592), .Z(n1_adj_899)) /* synthesis lut_function=(!(A (B (D)+!B (C+(D)))+!A (((D)+!C)+!B))) */ ;   // c:/lscc/ep16vhdl/gpio16.vhd(54[3] 61[12])
    defparam addr_1__I_0_Mux_9_i1_4_lut.init = 16'h00ca;
    ORCALUT4 i7239_4_lut (.A(n1171), .B(gpio_dir[7]), .C(n8622), .D(n8592), 
            .Z(n1_adj_900)) /* synthesis lut_function=(!(A (B (C (D))+!B (C))+!A (((D)+!C)+!B))) */ ;   // c:/lscc/ep16vhdl/gpio16.vhd(54[3] 61[12])
    defparam i7239_4_lut.init = 16'h0aca;
    ORCALUT4 i1654_4_lut (.A(ioport_out_7), .B(\rx_buffer_reg[7] ), .C(data_o_15__N_441), 
            .D(n8622), .Z(n2378)) /* synthesis lut_function=(A (B ((D)+!C)+!B !(C))+!A (B (C (D)))) */ ;   // c:/lscc/ep16vhdl/gpio16.vhd(54[3] 61[12])
    defparam i1654_4_lut.init = 16'hca0a;
    PFUMX i1470 (.BLUT(ioport_out_0), .ALUT(n2193), .C0(data_o_15__N_441), 
          .Z(n2194));
    
endmodule
//
// Verilog Description of module PUR
// module not written out since it is a black-box. 
//

//
// Verilog Description of module uart
//
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
