DRuffer/eP16VHDL/(commit log)

2016-06-12 Check in all of the Diamond artifacts. Get signon, butno I/O.
    [eP16_eP16_mapvho.sdf, eP16_eP16_mapvo.sdf]
2016-06-12 Add simulation files, but not sure they are right yet.
    [compile.cfg, library.cfg, projlib.cfg]
2016-06-20 Got the I/O to work properly?
    [eP16_eP16_mapvho.sdf, eP16_eP16_mapvo.sdf]
